lecejeff/dsPeak/Hardware/Daughter Card/v1_00-0a/pcb output files/step/Daughter_card-v1_00-0a.stp

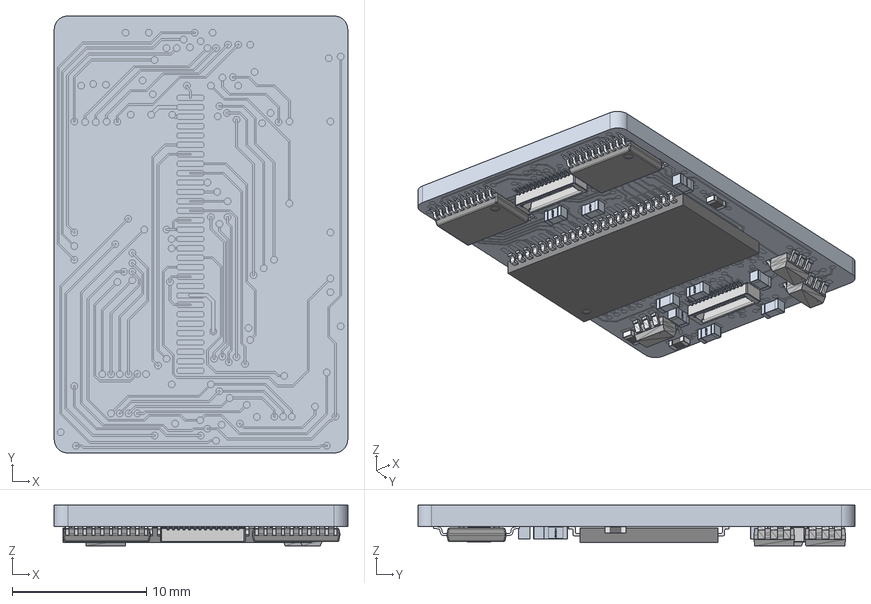
[picture p1: CAD file, 2021-03-09]
Hardware/Daughter Card/v1_00-0a/pcb output files/step/Daughter_card-v1_00-0a.stp
21.8 x 32.5 x 3.05 mm
BOARD_OUTLINE
CIRCLE_50801 x 120
RECTROUND_3988.000000_19990.000000_1321.000000_11111 x 30
TRACES_TOP
SHAPES_TOP
CIRCLE_50804 x 120
RECTROUND_5994.000000_9500.000000_991.000000_11114 x 24
RECTROUND_5994.000000_10998.000000_991.000000_11114 x 15
RECTROUND_15494.000000_2489.000000_838.000000_11114 x 40
RECTROUND_2007.000000_7010.000000_660.000000_11114 x 48
RECTROUND_3505.000000_7010.000000_660.000000_11114 x 8
RECTROUND_21996.000000_4089.000000_1372.000000_11114 x 44
TRACES_BOTTOM
SHAPES_BOTTOM
RESC1608X50N_EIA_0603_METRIC_1608_157x085x050 x 3
product x 3
BODY-TSSOP x 2
LEAD-TSSOP x 40
PIN1 x 2
DF40C-30DP-0.4Vnew x 2
leg_TSSOP44 x 264
Part TSSOP44
