lecejeff/dsPeak/Hardware/v1_00-0a/3dprints/dsPeak top.stl

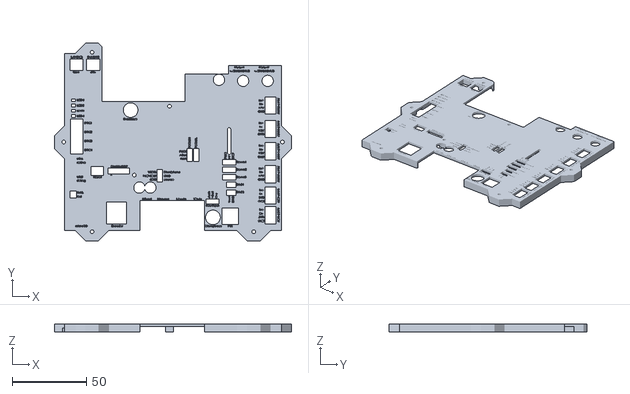
[picture p2: CAD file, 2021-01-17]
Hardware/v1_00-0a/3dprints/dsPeak top.stl
159.4 x 132.8 x 5.71
