lecejeff/dsPeak/Hardware/v1_00-0a/3dprints/dsPeak base.stl

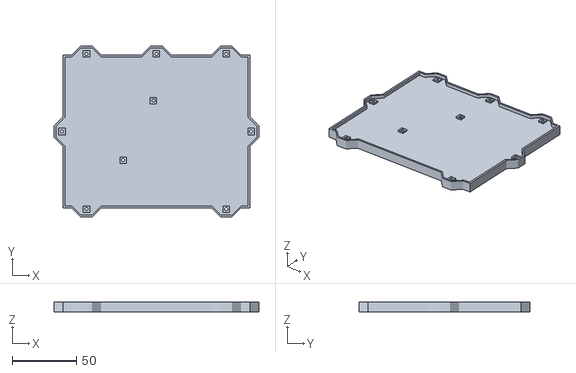
[picture p3: CAD file, 2021-01-17]
Hardware/v1_00-0a/3dprints/dsPeak base.stl
159.4 x 132.8 x 8.00
