lecejeff/dsPeak/Hardware/v1_00-0b/schema_pdf/dspeak-v1_00-0b-PCB.pdf

# ART FILM - TOP

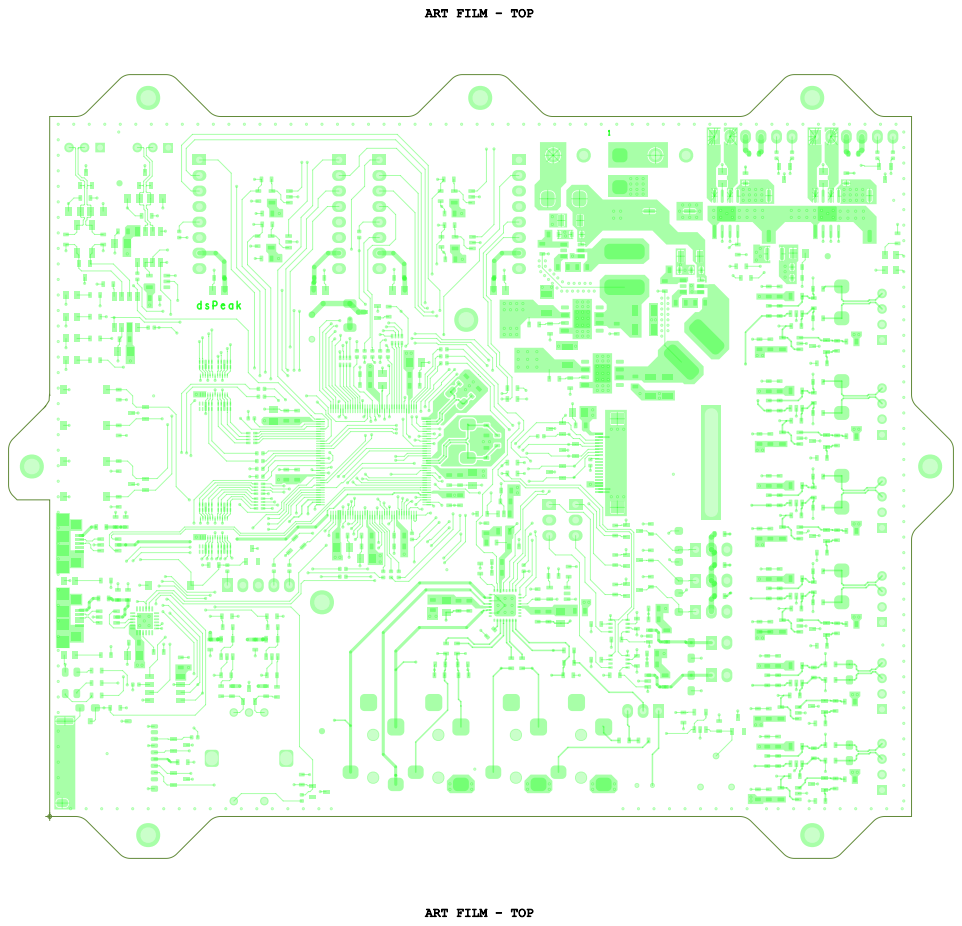
[picture p4: page 1]
dsPeak

ART FILM - TOP

# ART FILM - INNER1

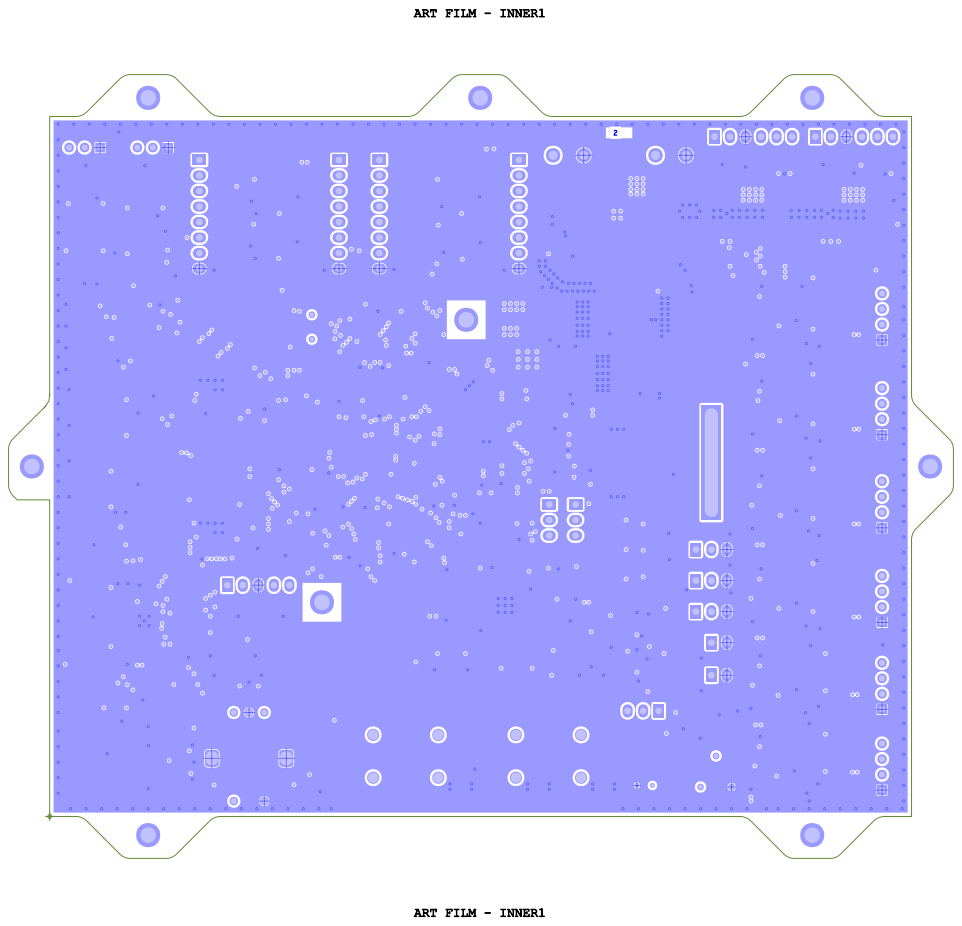
[picture p5: page 2]
ART FILM - INNER1

# ART FILM - INNER2

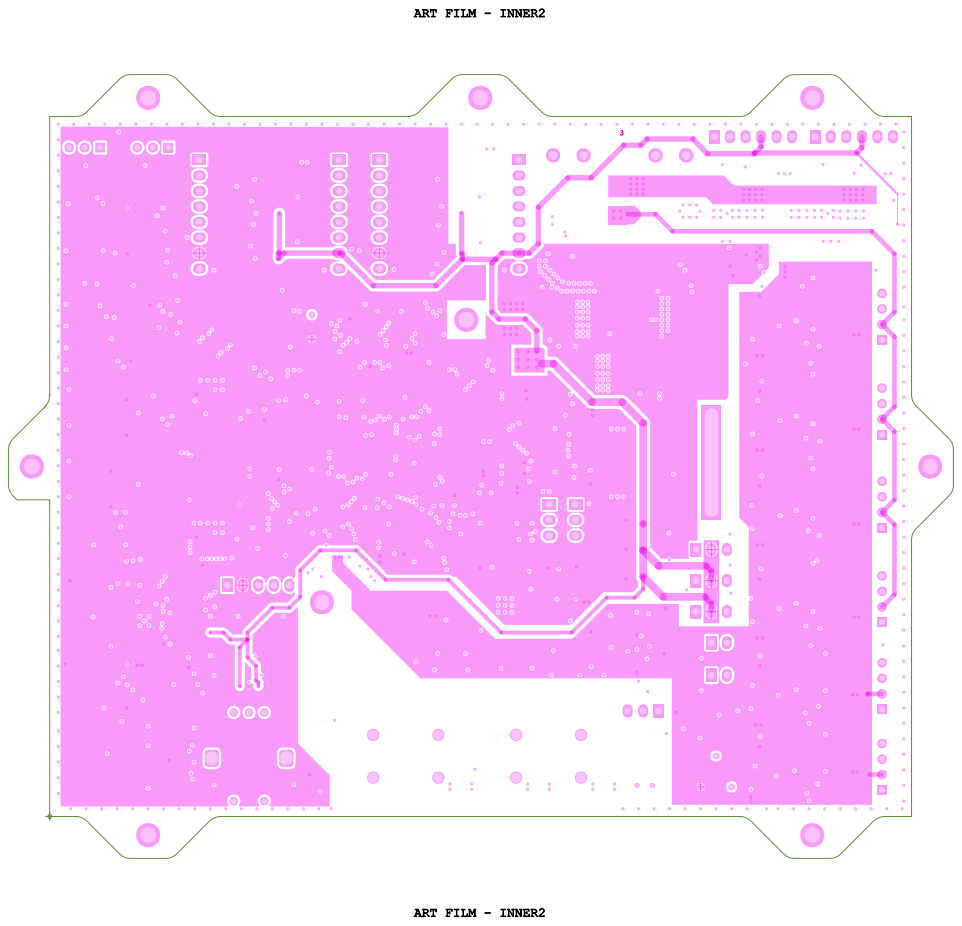
[picture p6: page 3]
ART FILM - INNER2

# ART FILM - BOTTOM

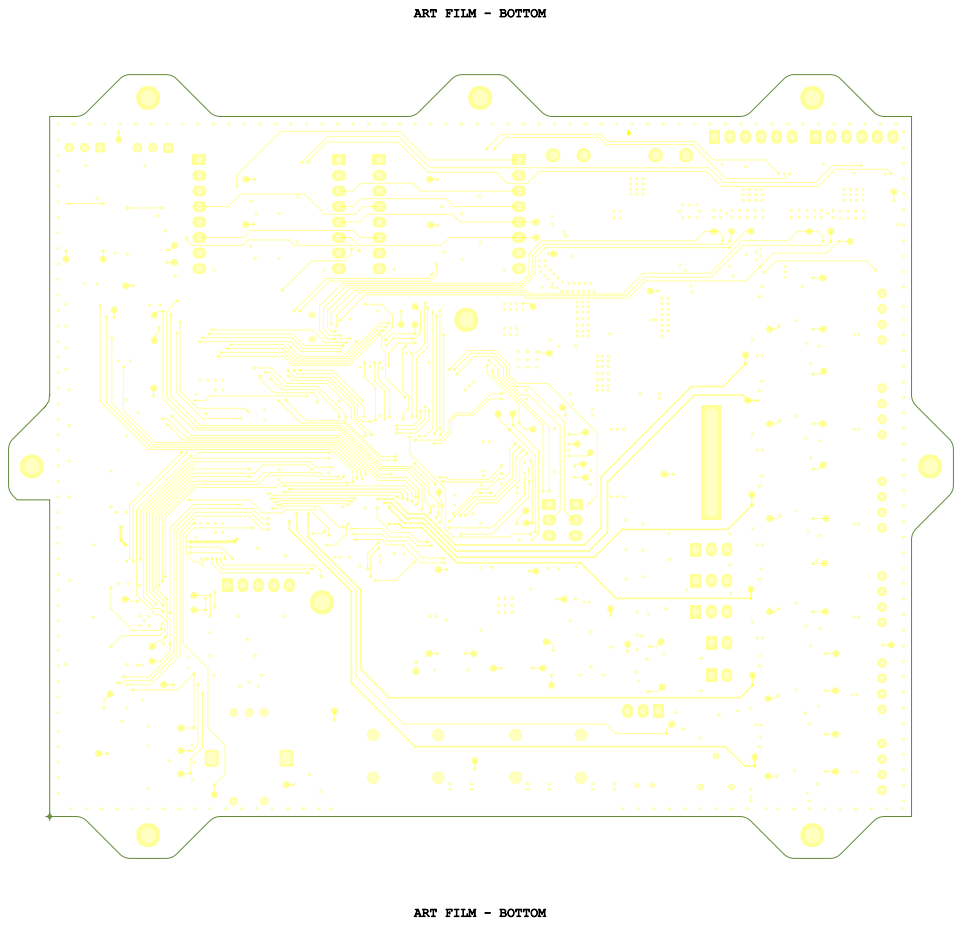
[picture p7: page 4]

ART FILM - BOTTOM

# ART FILM - SoldermaskTop

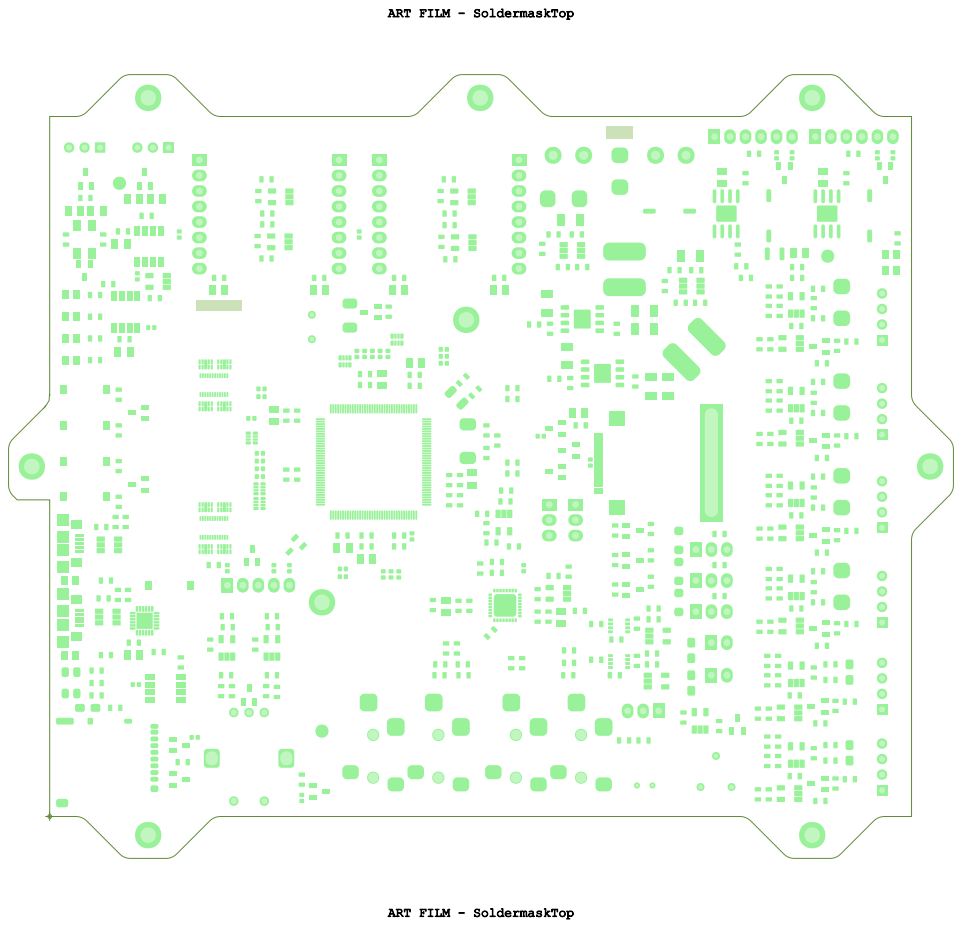
[picture p8: page 5]

ART FILM - SoldermaskTop

# ART FILM - SoldermaskBot

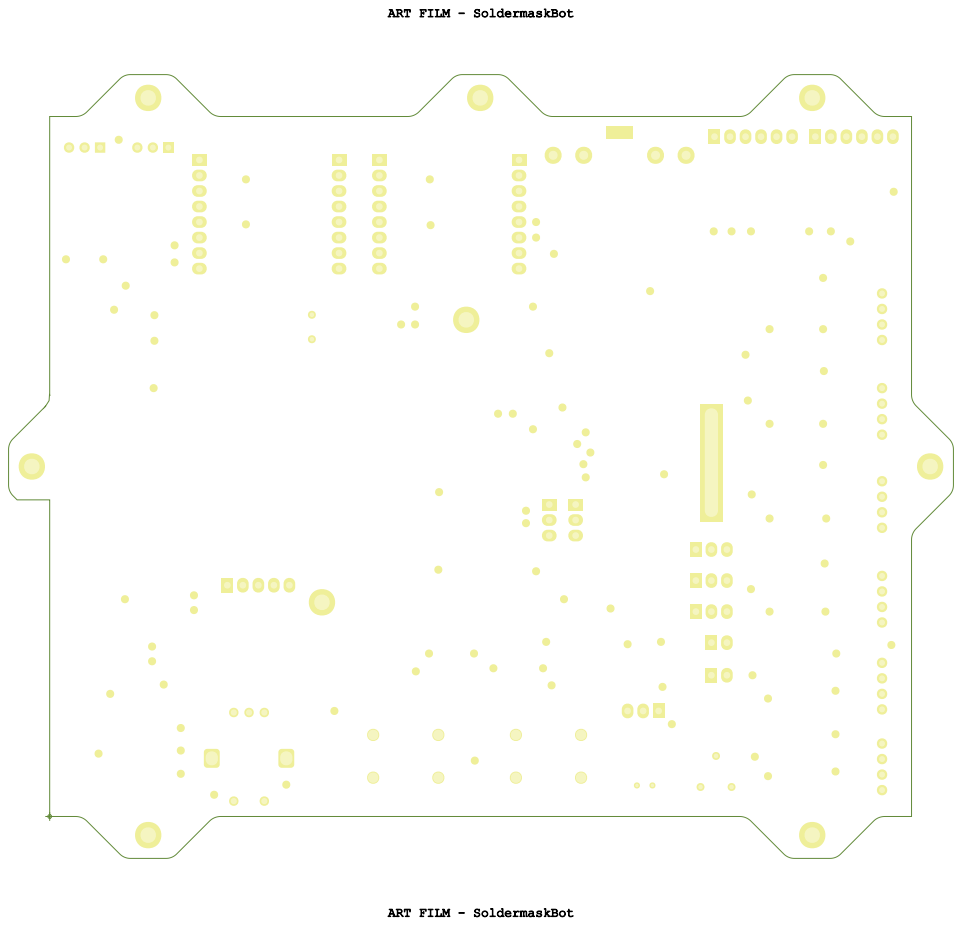
[picture p9: page 6]

ART FILM - SoldermaskBot

# ART FILM - SilkscreenTop

D49R57

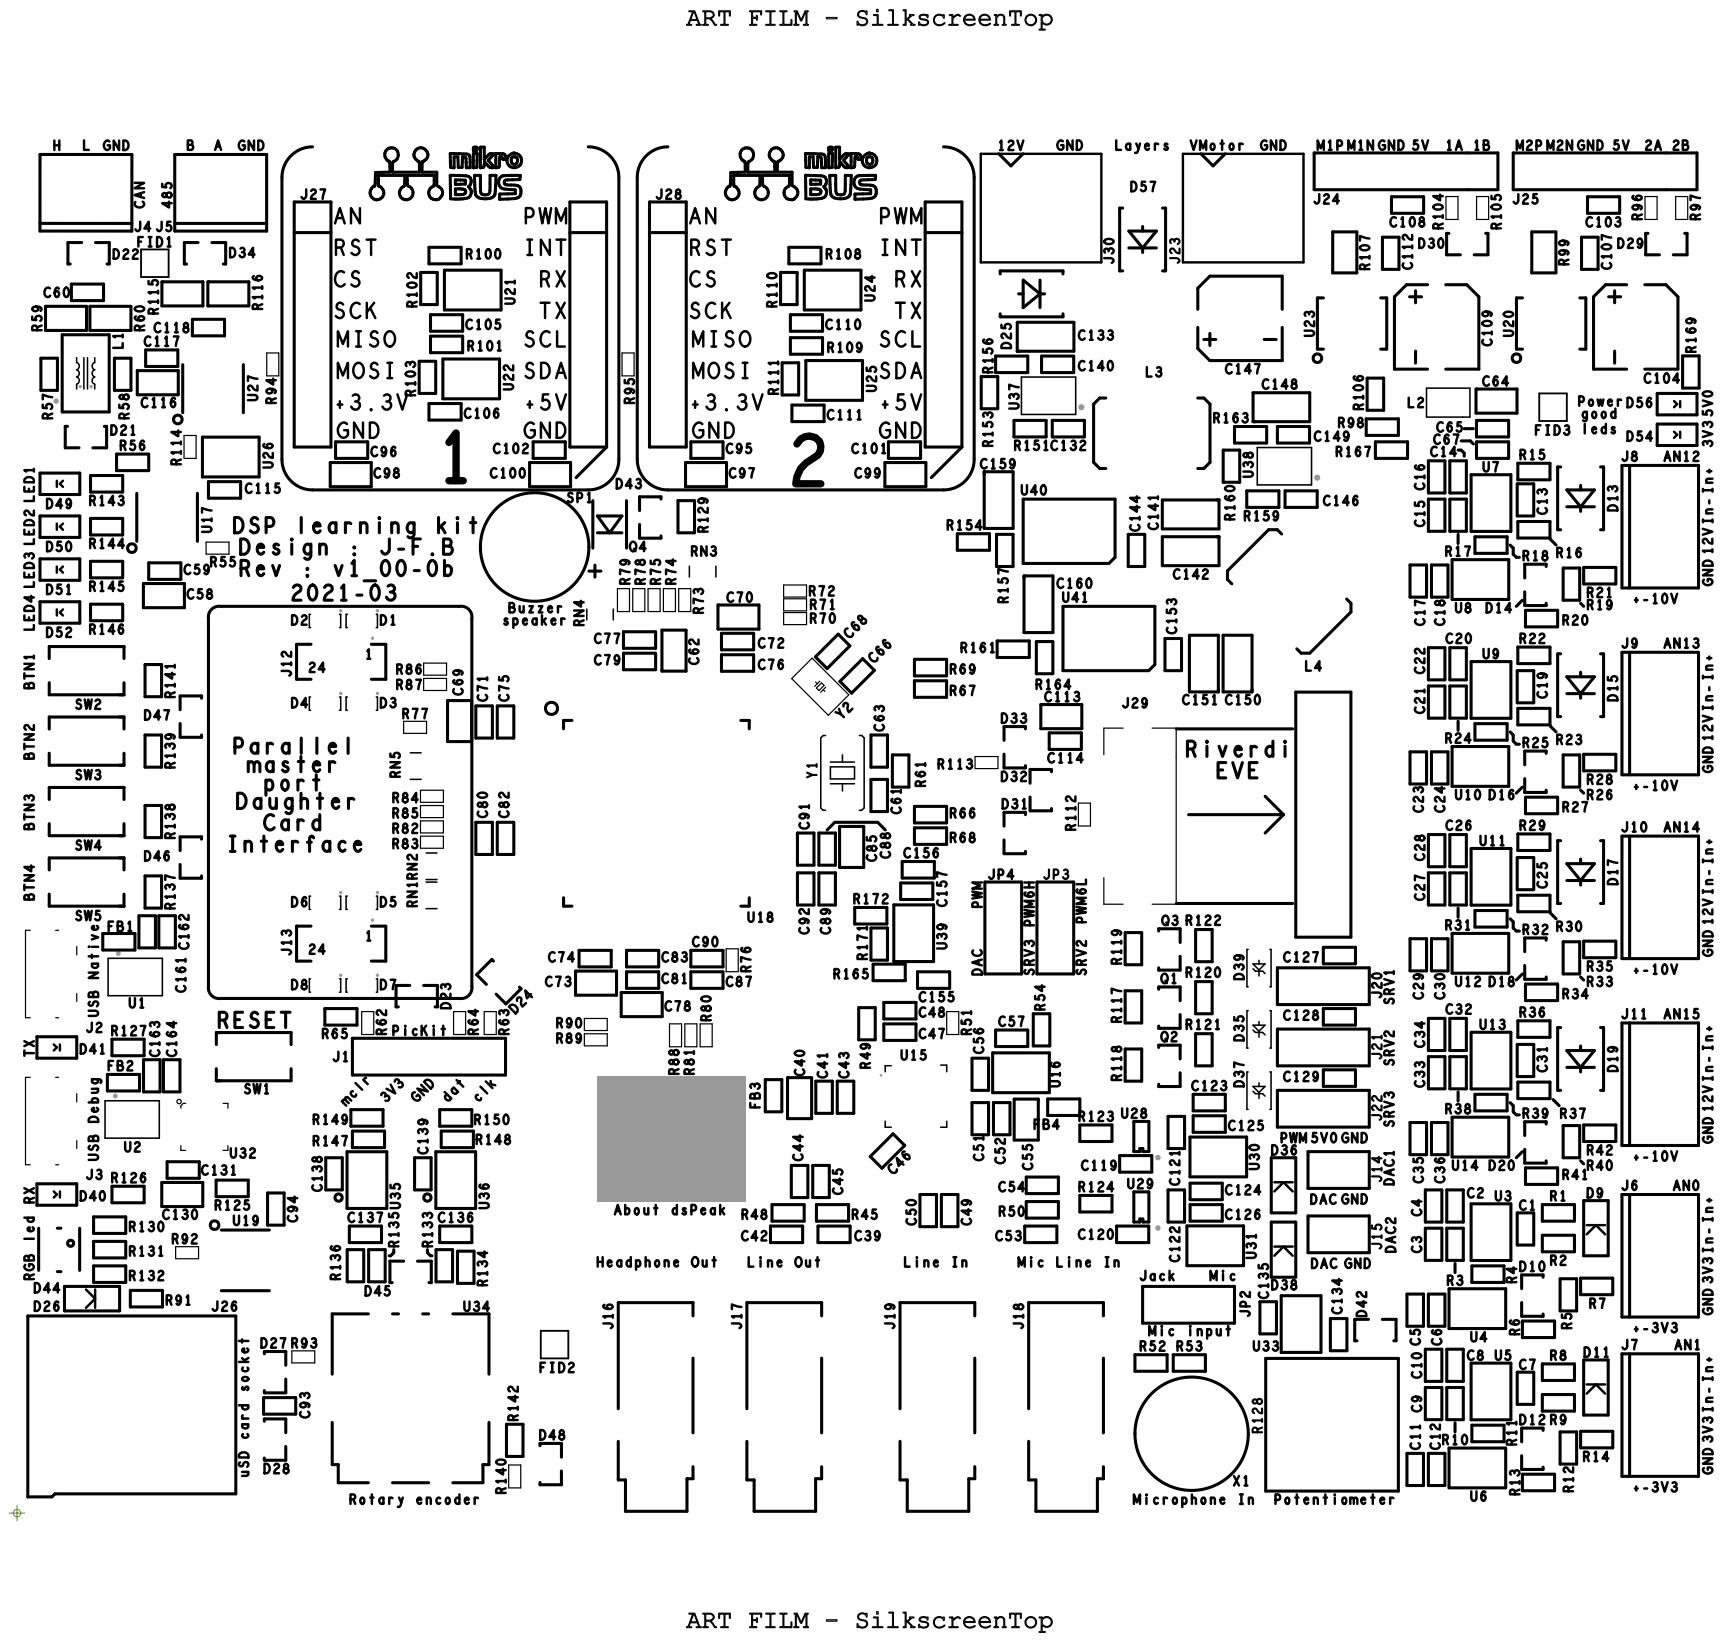
[picture p10: page 7]

3V3 GND In+ In- GND In- 3V3 In+ GND In- 12V In+ GND In- 12V In+ 12V GND In+ In- GND 12V In- In+ 3V3 5V0

RGB led D44 RX TX BTN4 BTN3 BTN2 BTN1 LED4

# ART FILM - SilkscreenBot

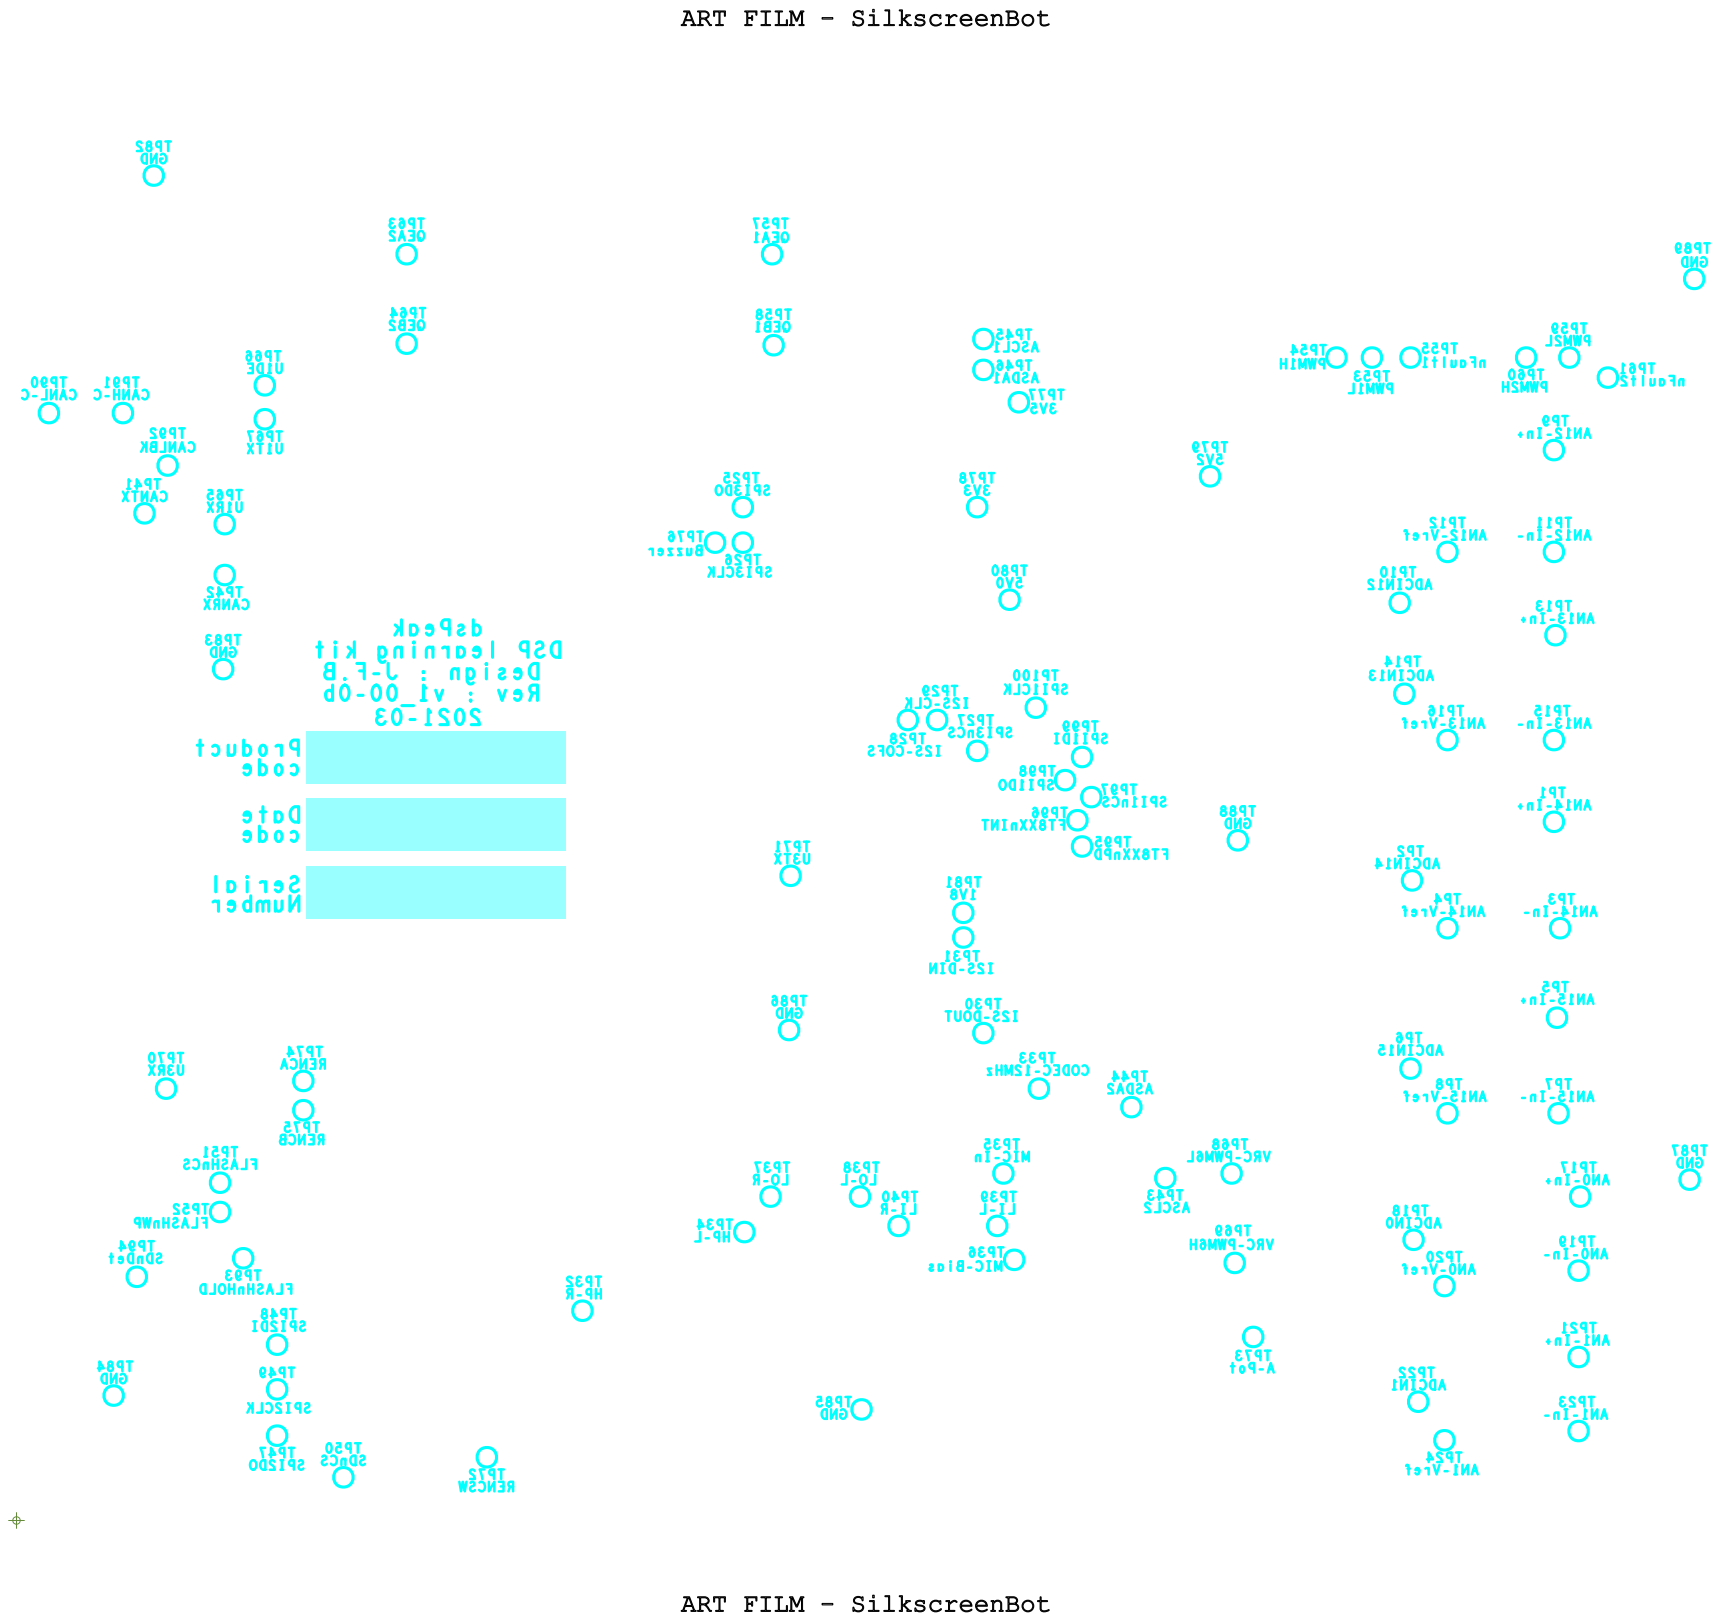
[picture p11: page 8]

# ART FILM - Outline

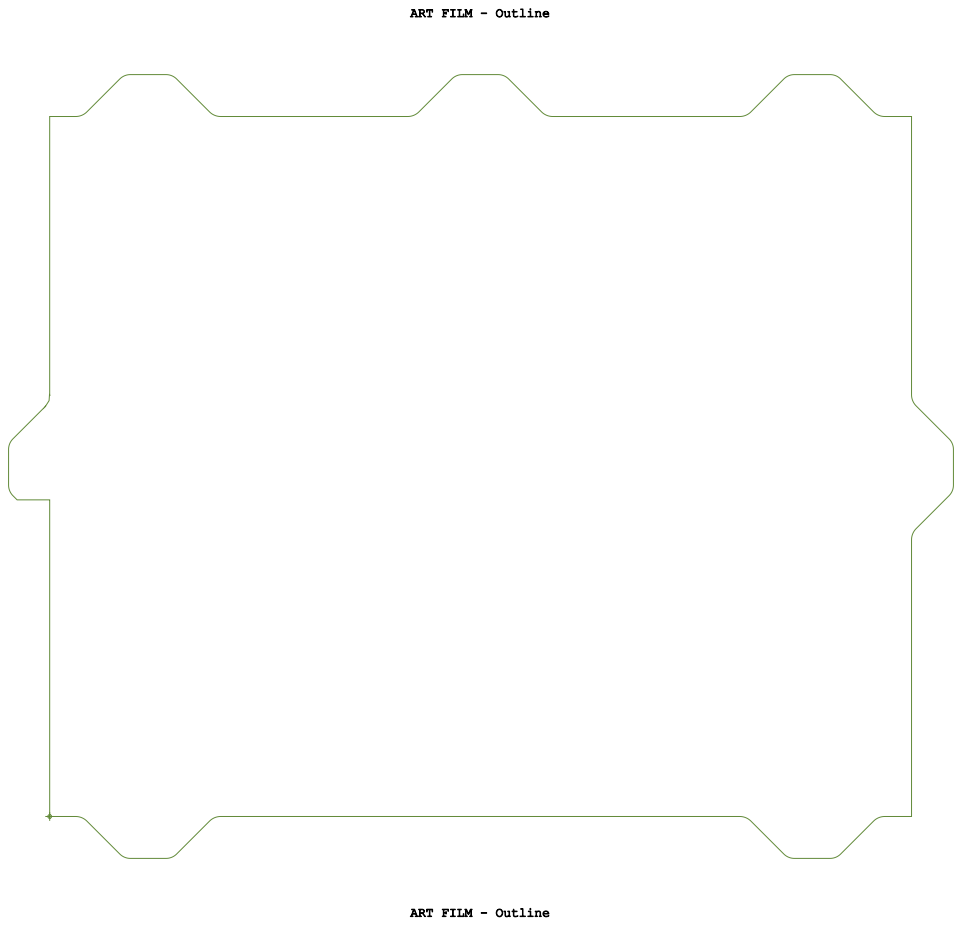
[picture p12: page 9]

ART FILM - Outline
