lecejeff/dsPeak/Hardware/v1_00-0a/schema_pdf/dspeak-v1_00-0a-SCH.pdf

CAN_TX CAN_RX CAN_LBK UART1_TX UART1_RTS UART1_CTS UART1_RX MKB1_AIN MKB1_PWM MKB1_INT MKB1_nCS MKB1_RST ASDA1 ASCL1 UART2_TX UART2_RX SPI4_MISO SPI4_MOSI SPI4_SCLK MKB2_AIN MKB2_PWM MKB2_INT MKB2_nCS MKB2_RST

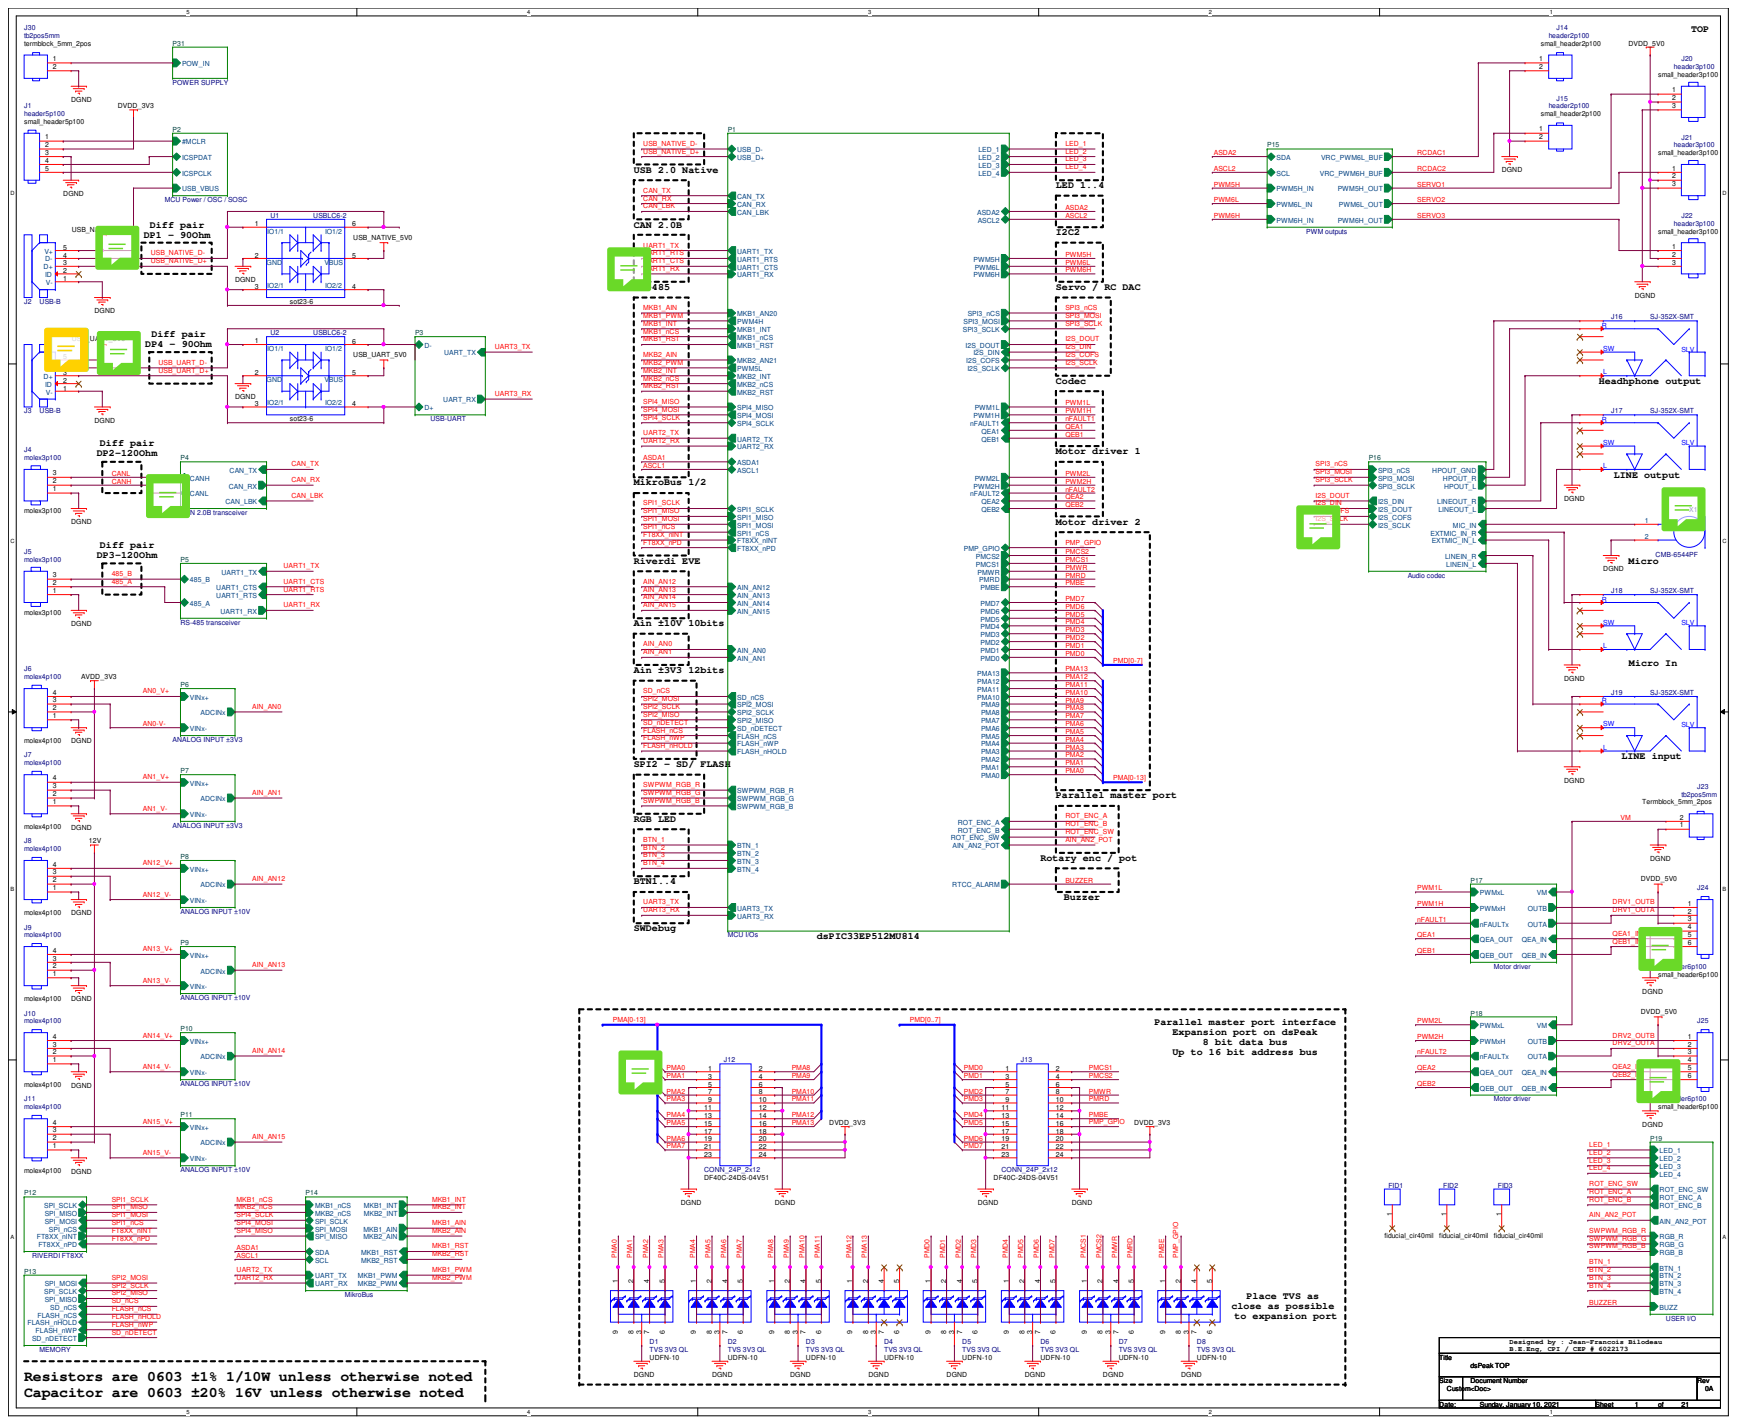
[picture p13: page 1]

USB_VBUS
MCU Power / OSC / SOSC

Parallel master port interface
Expansion port on dsPeak

Up to 16 bit address bus

Designed by : Jean-Francois Bilodeau
B.E.Eng, CPI / CEP # 6022173

Resistors are 0603 ±1% 1/10W unless otherwise noted
Capacitor are 0603 ±20% 16V unless otherwise noted

D D

# Analog input ±10V

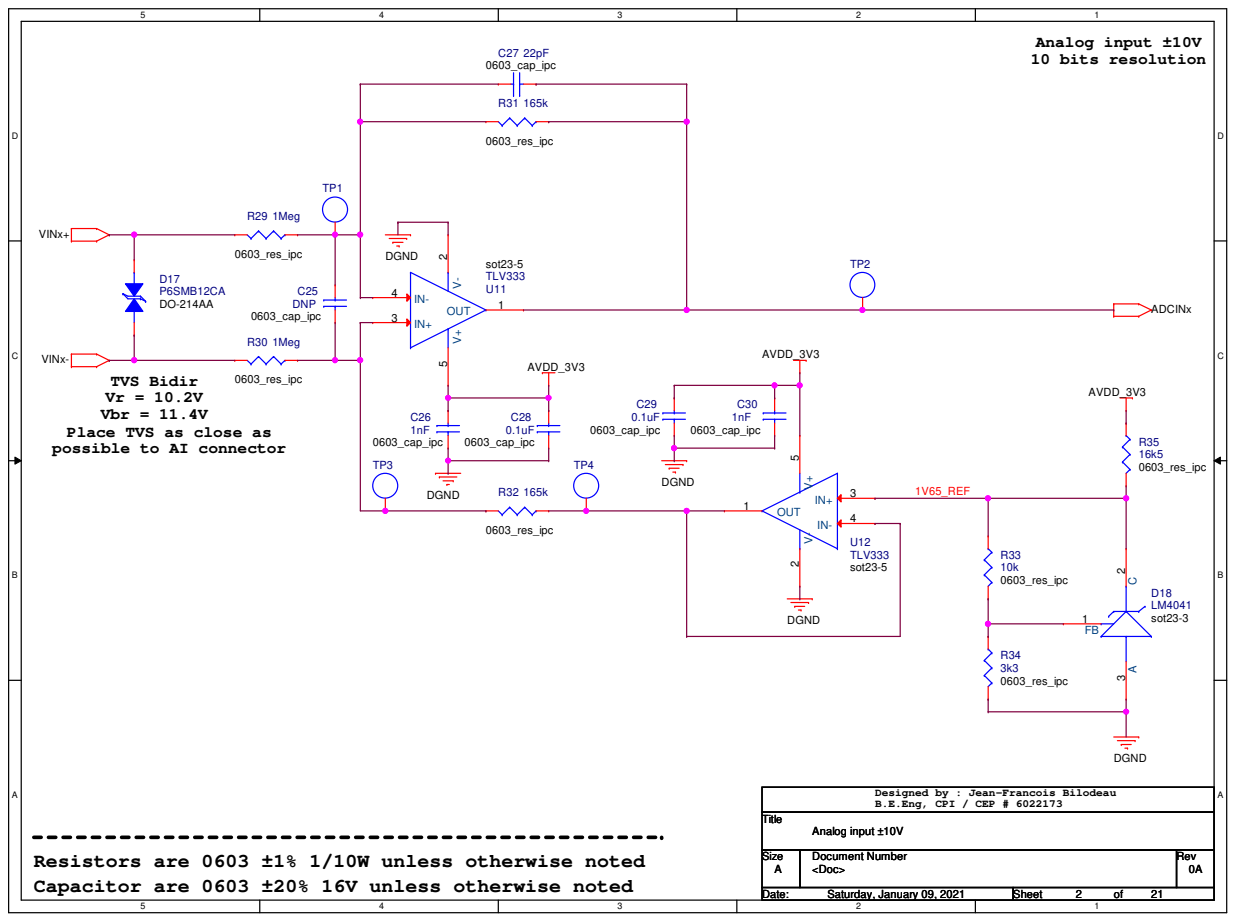
[picture p14: page 2]

TVS Bidir
Vbr = 11.4V
Place TVS as close as
possible to AI connector

Designed by : Jean-Francois Bilodeau
B.E.Eng, CPI / CEP # 6022173

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

D D

# Analog input ±10V

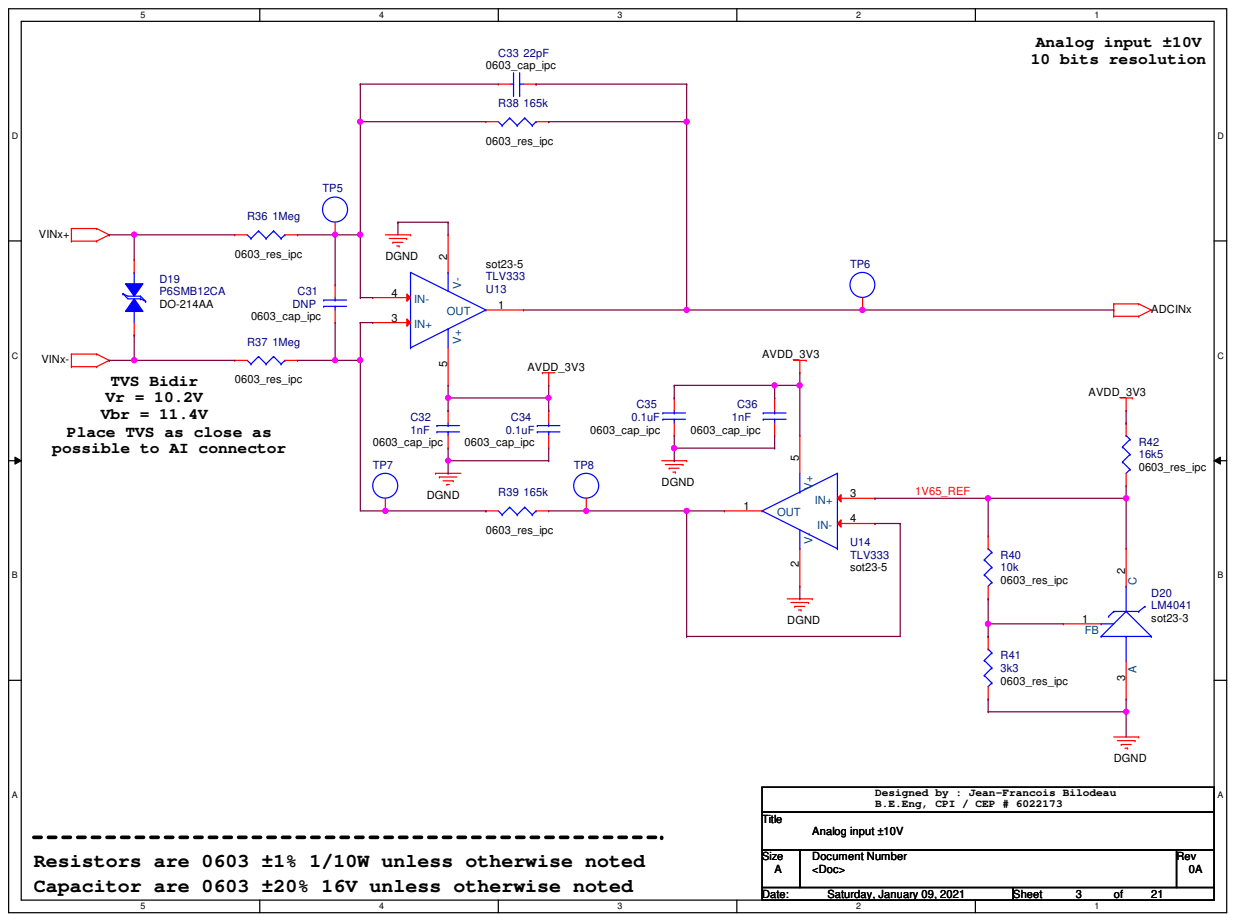
[picture p15: page 3]

TVS Bidir
Vbr = 11.4V
Place TVS as close as
possible to AI connector

Designed by : Jean-Francois Bilodeau
B.E.Eng, CPI / CEP # 6022173

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

D D

# Analog input ±10V

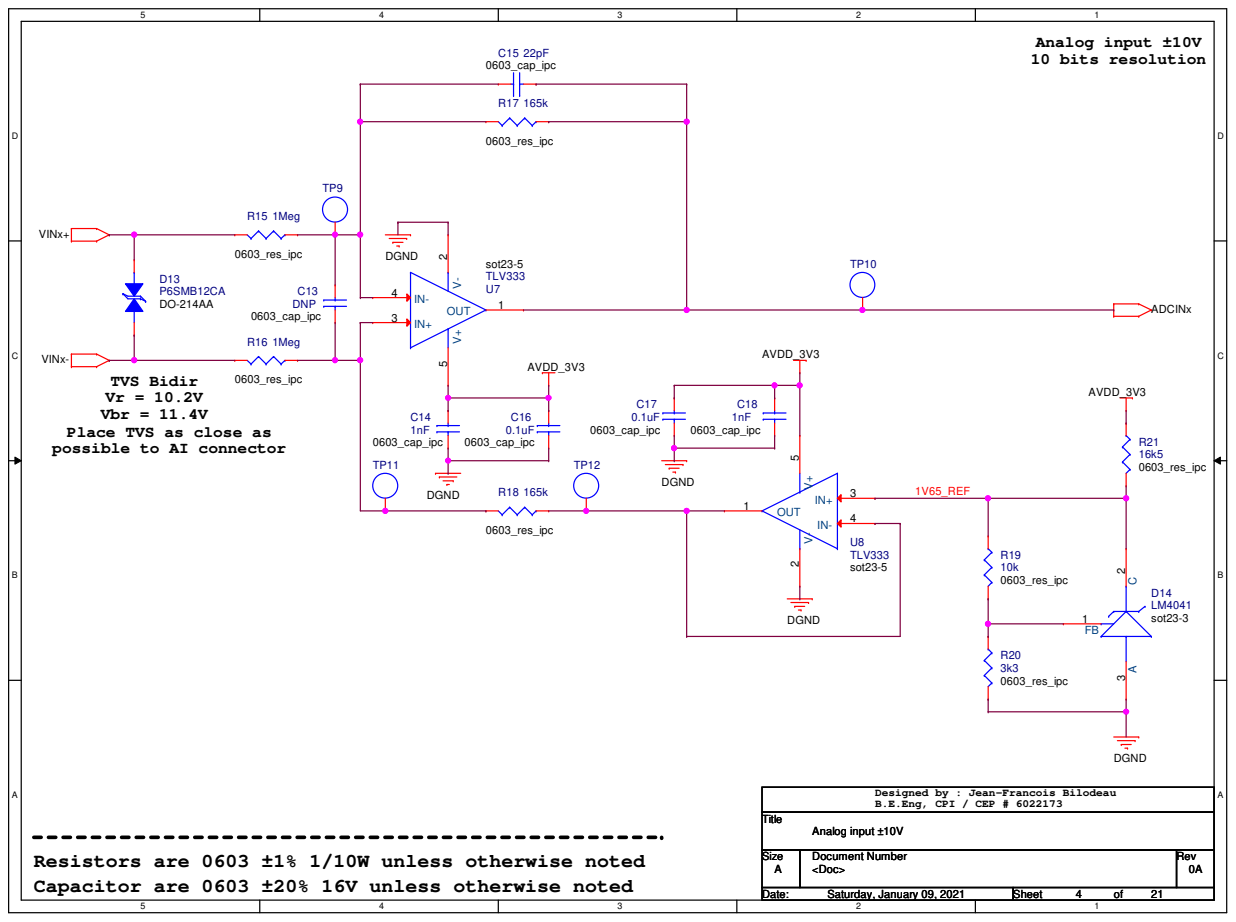
[picture p16: page 4]

TVS Bidir
Vbr = 11.4V
Place TVS as close as
possible to AI connector

Designed by : Jean-Francois Bilodeau
B.E.Eng, CPI / CEP # 6022173

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

D D

# Analog input ±10V

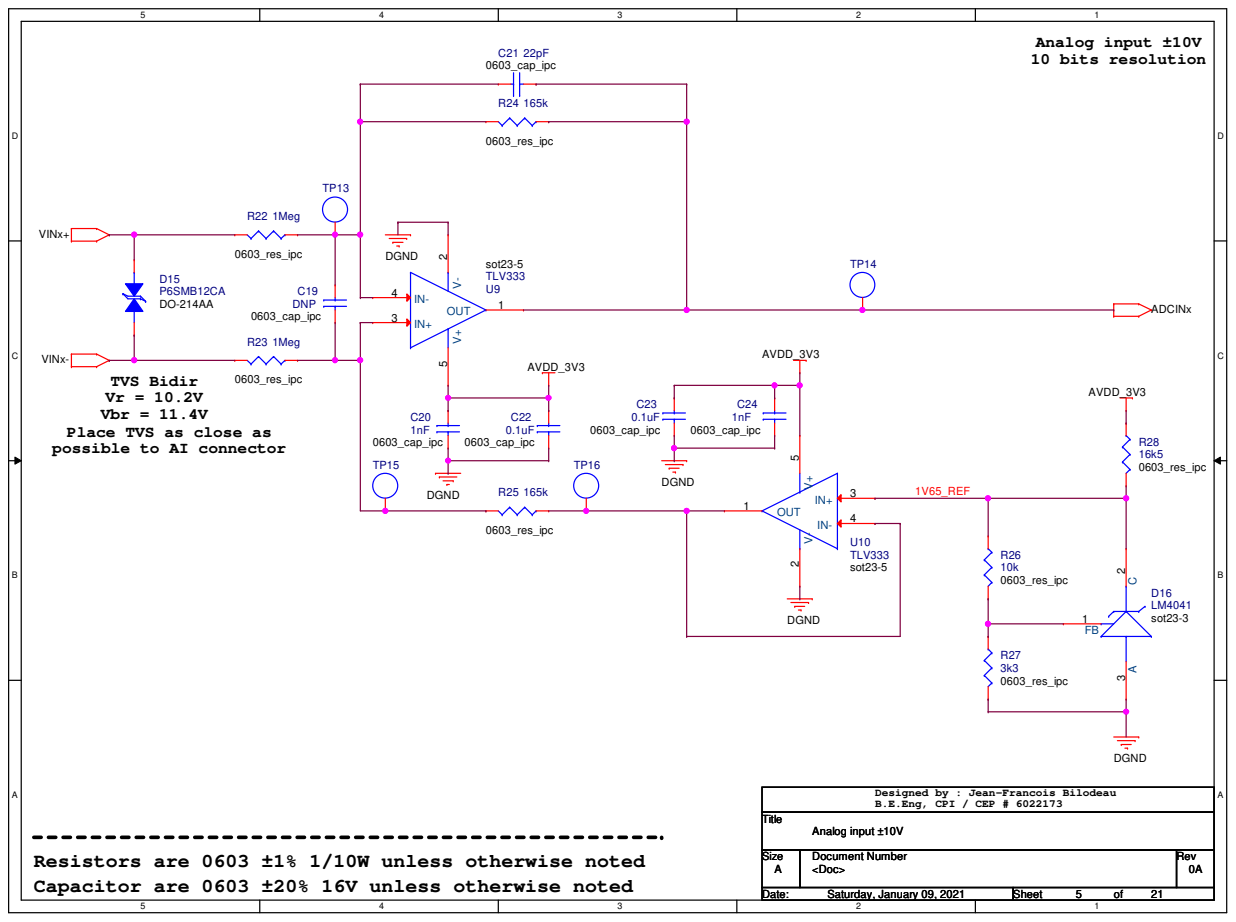
[picture p17: page 5]

TVS Bidir
Vbr = 11.4V
Place TVS as close as
possible to AI connector

Designed by : Jean-Francois Bilodeau
B.E.Eng, CPI / CEP # 6022173

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

D D

# Analog input ±3.3V

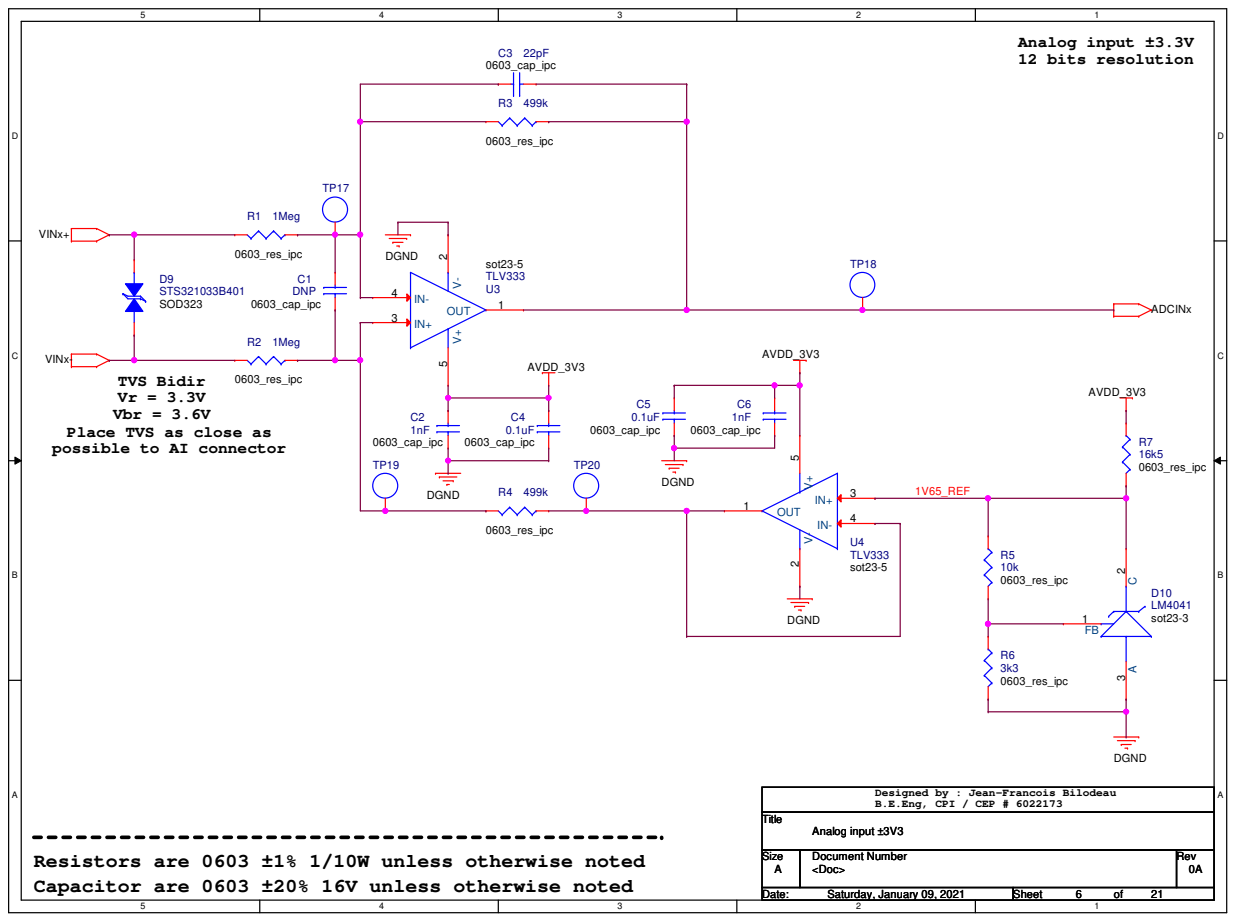
[picture p18: page 6]

Place TVS as close as
possible to AI connector

Designed by : Jean-Francois Bilodeau
B.E.Eng, CPI / CEP # 6022173

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

D D

# Analog input ±3.3V

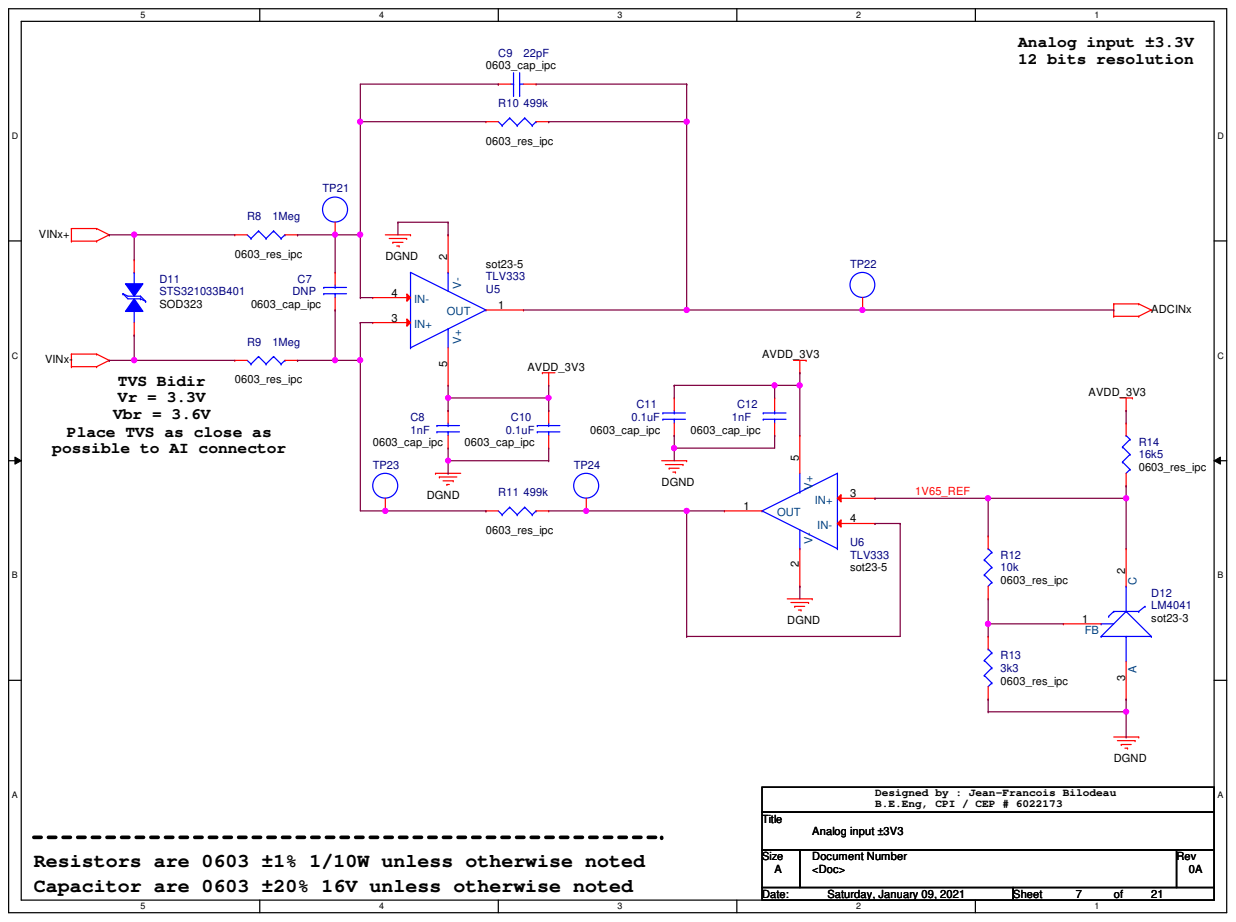
[picture p19: page 7]

Place TVS as close as
possible to AI connector

Designed by : Jean-Francois Bilodeau
B.E.Eng, CPI / CEP # 6022173

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

### Place as close as possible to IC pin

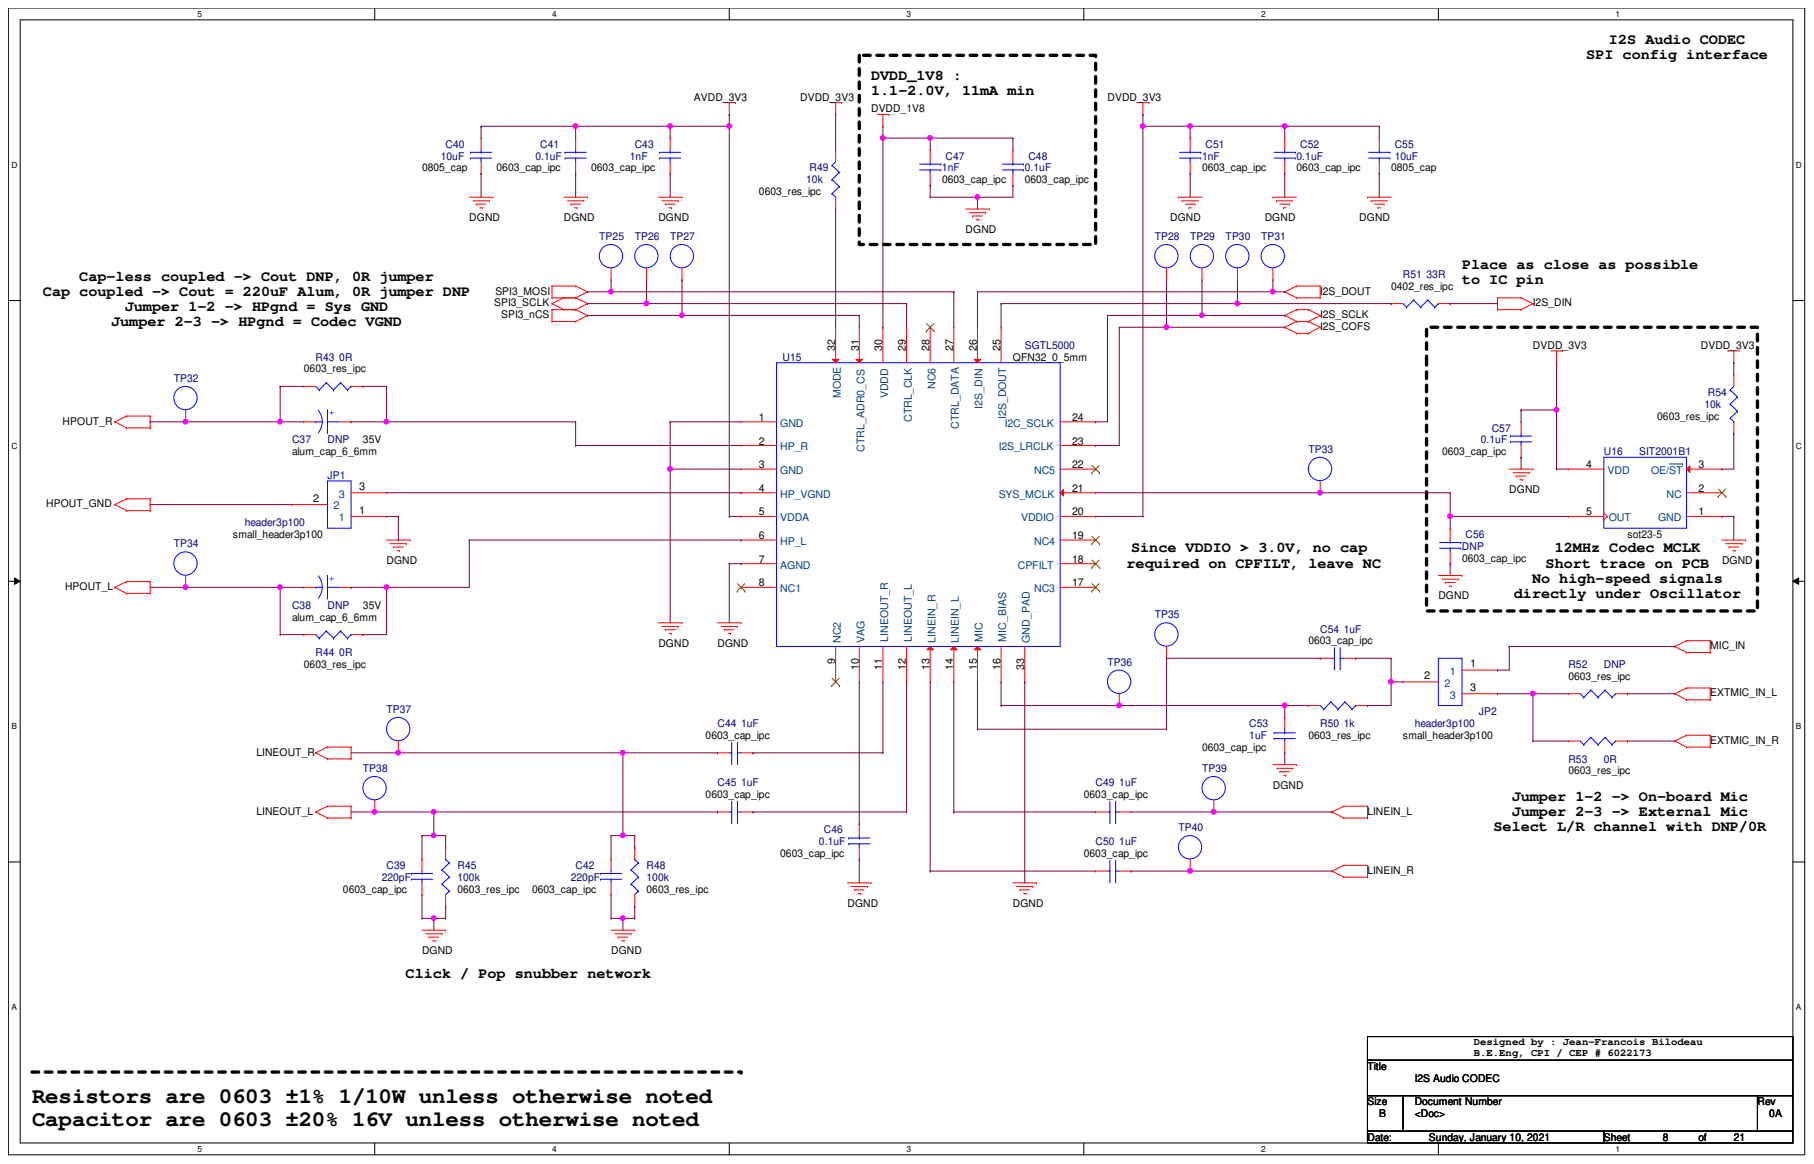
[picture p20: page 8]

Cap-less coupled -> Cout DNP, 0R jumper
Cap coupled -> Cout = 220uF Alum, 0R jumper DNP

Jumper 1-2 -> HPgnd = Sys GND
Jumper 2-3 -> HPgnd = Codec VGND

Since VDDIO > 3.0V, no cap
required on CPFILT, leave NC

12MHz Codec MCLK
Short trace on PCB
No high-speed signals
directly under Oscillator

Jumper 1-2 -> On-board Mic
Jumper 2-3 -> External Mic
Select L/R channel with DNP/0R

Click / Pop snubber network

Designed by : Jean-Francois Bilodeau
B.E.Eng, CPI / CEP # 6022173

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

D D

# CAN bus interface

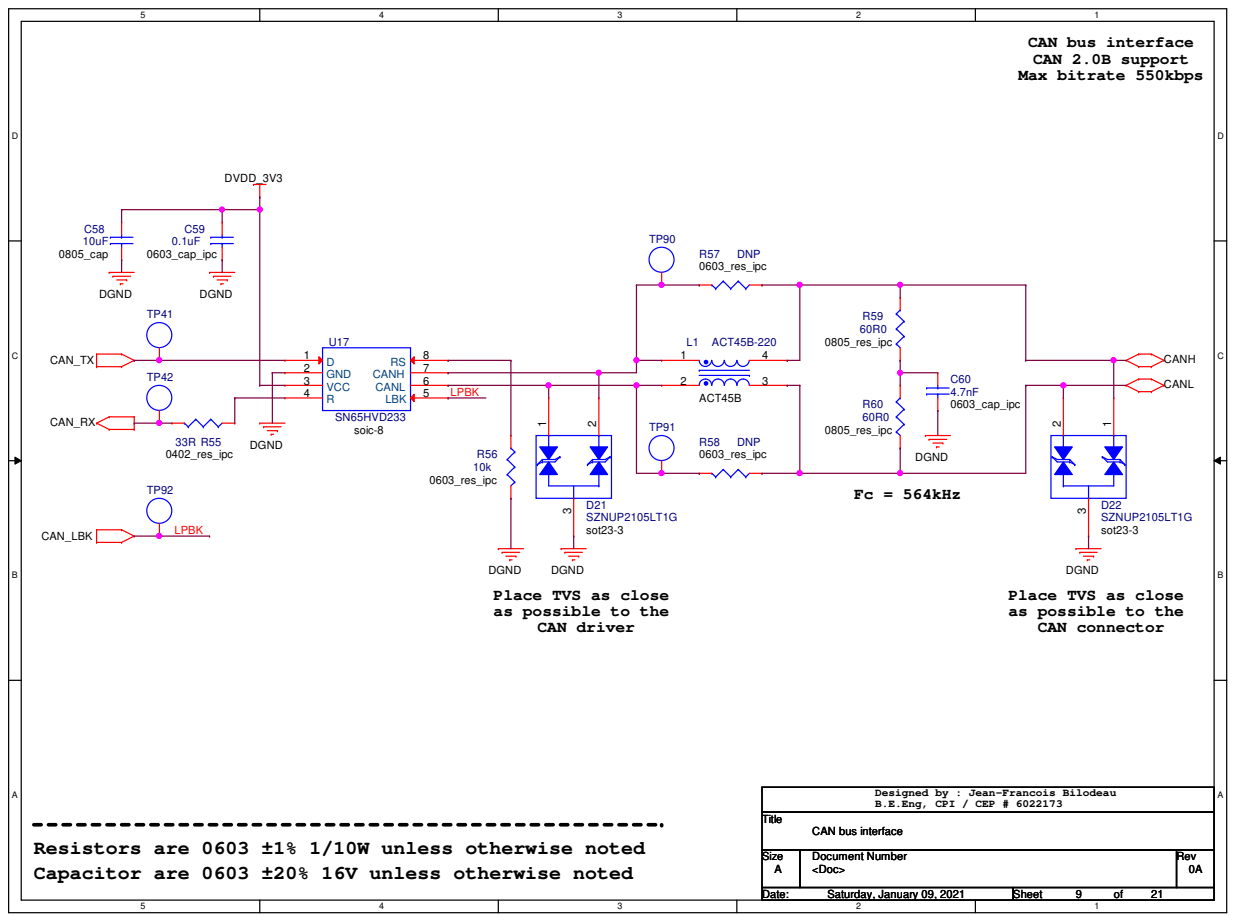
[picture p21: page 9]

Place TVS as close
as possible to the

CAN connector

Designed by : Jean-Francois Bilodeau
B.E.Eng, CPI / CEP # 6022173

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

### MCU decoupling MCU oscillators

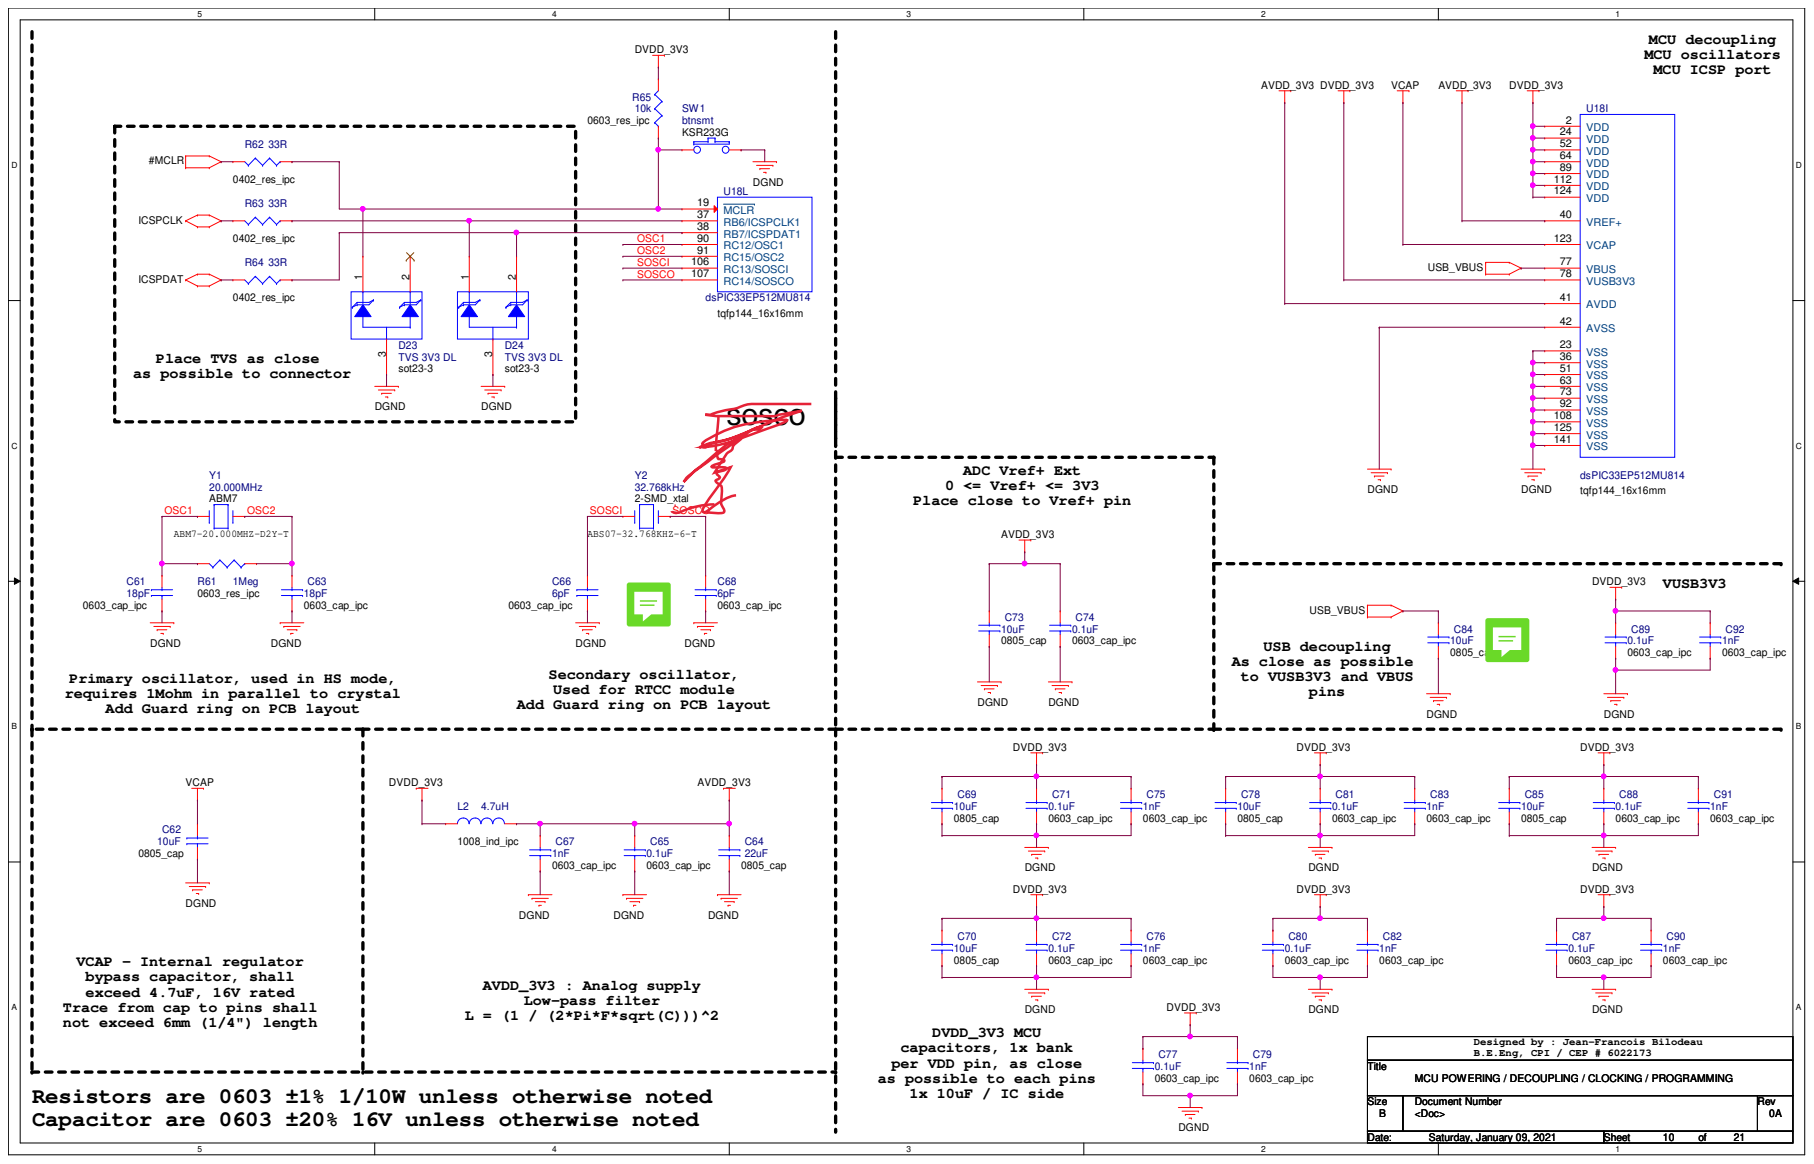
[picture p22: page 10]

Place TVS as close
as possible to connector

ADC Vref+ Ext
0 <= Vref+ <= 3V3
Place close to Vref+ pin

USB decoupling
As close as possible
to VUSB3V3 and VBUS

Primary oscillator, used in HS mode,
requires 1Mohm in parallel to crystal

Secondary oscillator,
Used for RTCC module
Add Guard ring on PCB layout

VCAP - Internal regulator
bypass capacitor, shall
exceed 4.7uF, 16V rated
Trace from cap to pins shall
not exceed 6mm (1/4") length

DVDD_3V3 MCU
capacitors, 1x bank
per VDD pin, as close
as possible to each pins
1x 10uF / IC side

Designed by : Jean-Francois Bilodeau
B.E.Eng, CPI / CEP # 6022173

MCU POWERING / DECOUPLING / CLOCKING / PROGRAMMING

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

### dsPIC33EP512MU814 GPIO pin mapping

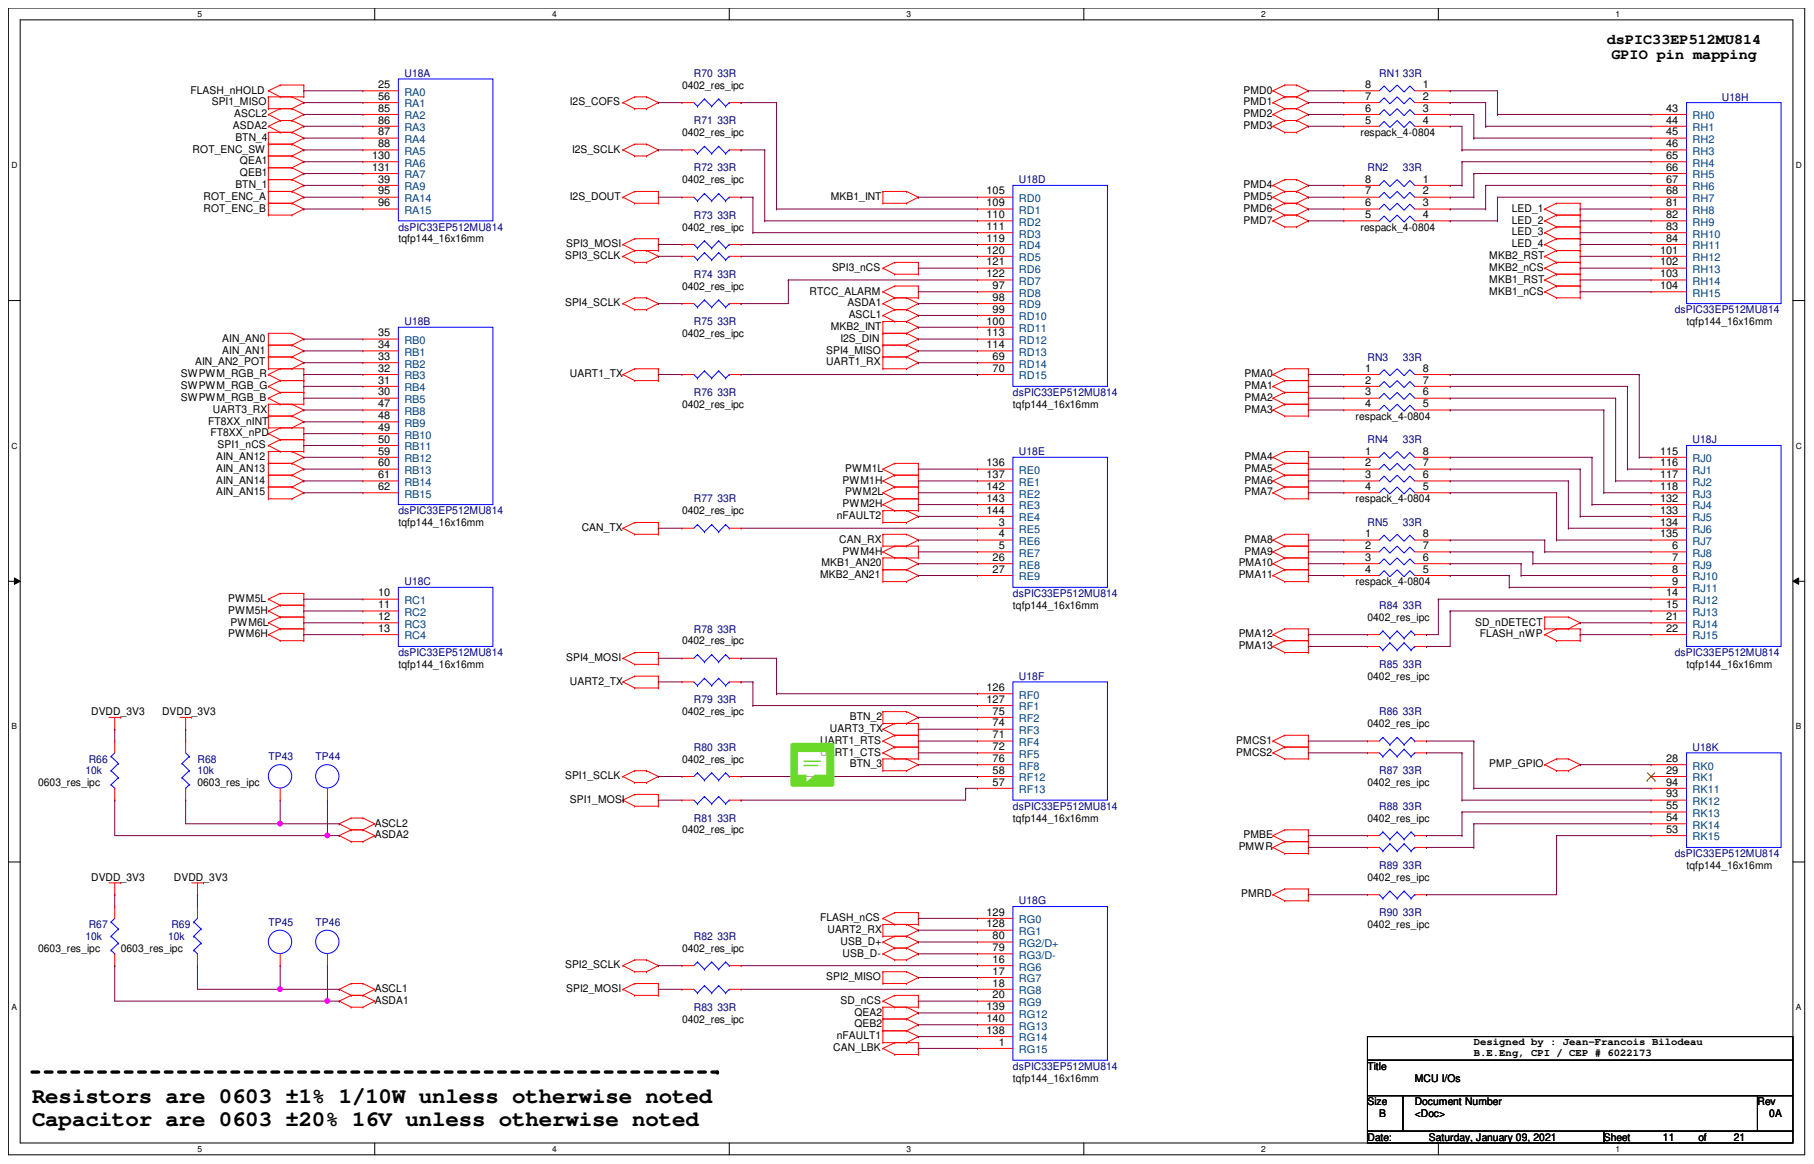
[picture p23: page 11]

Designed by : Jean-Francois Bilodeau
B.E.Eng, CPI / CEP # 6022173

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

D D

# Ext / Int memory

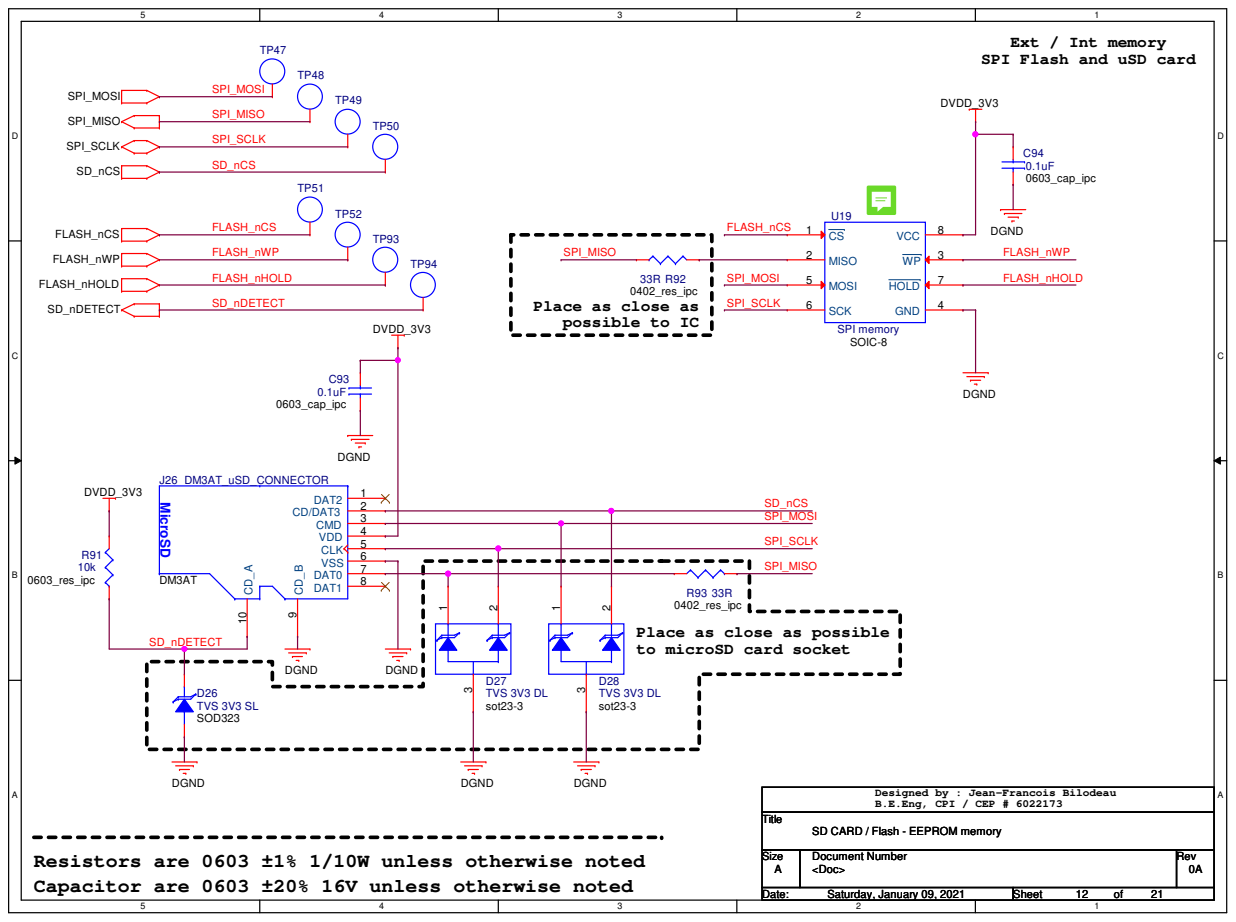
[picture p24: page 12]

SPI Flash and uSD card

Place as close as
possible to IC

0402_res_ipc
Place as close as possible
to microSD card socket

Designed by : Jean-Francois Bilodeau
B.E.Eng, CPI / CEP # 6022173

SD CARD / Flash - EEPROM memory

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

D D

# MikroBus port

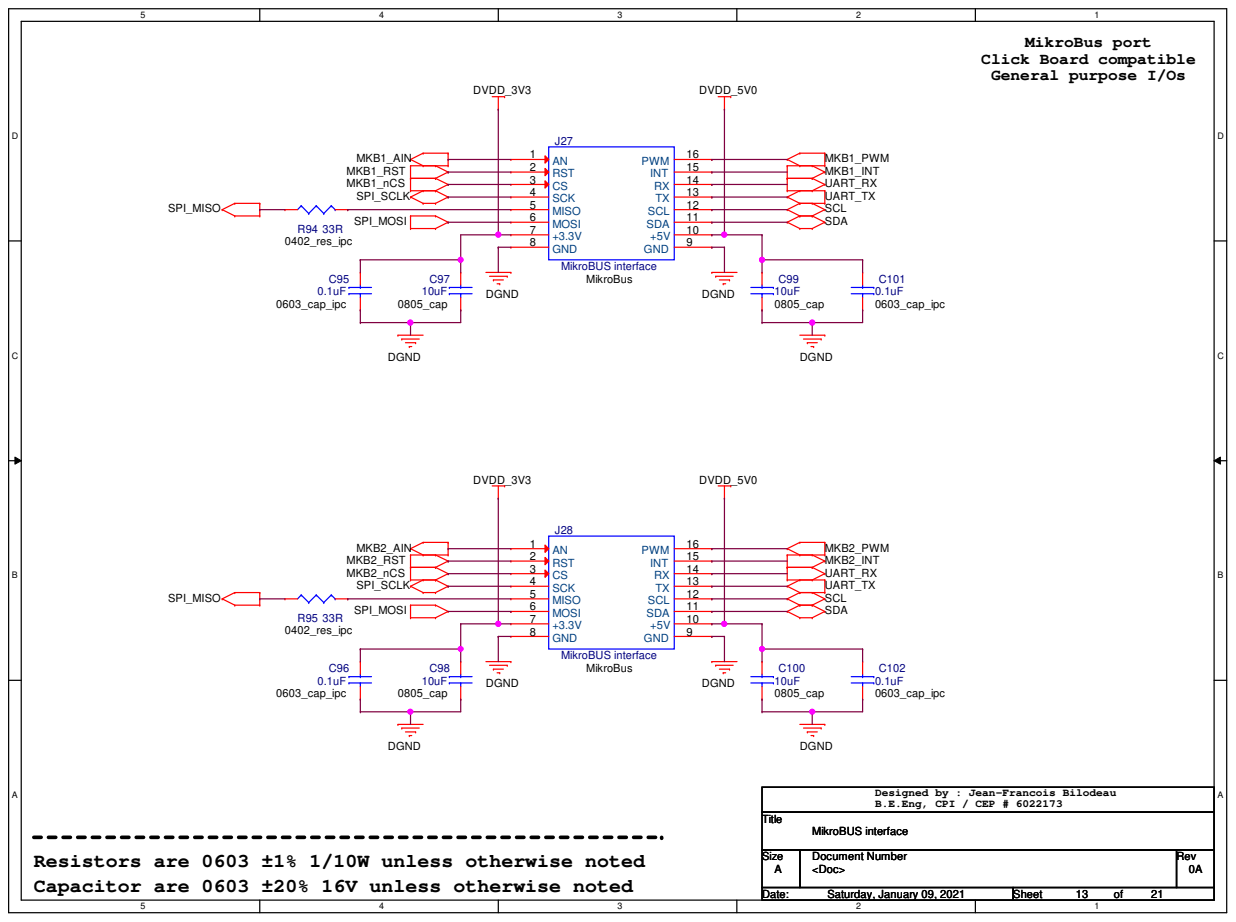
[picture p25: page 13]

Designed by : Jean-Francois Bilodeau
B.E.Eng, CPI / CEP # 6022173

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

### Voltage rating

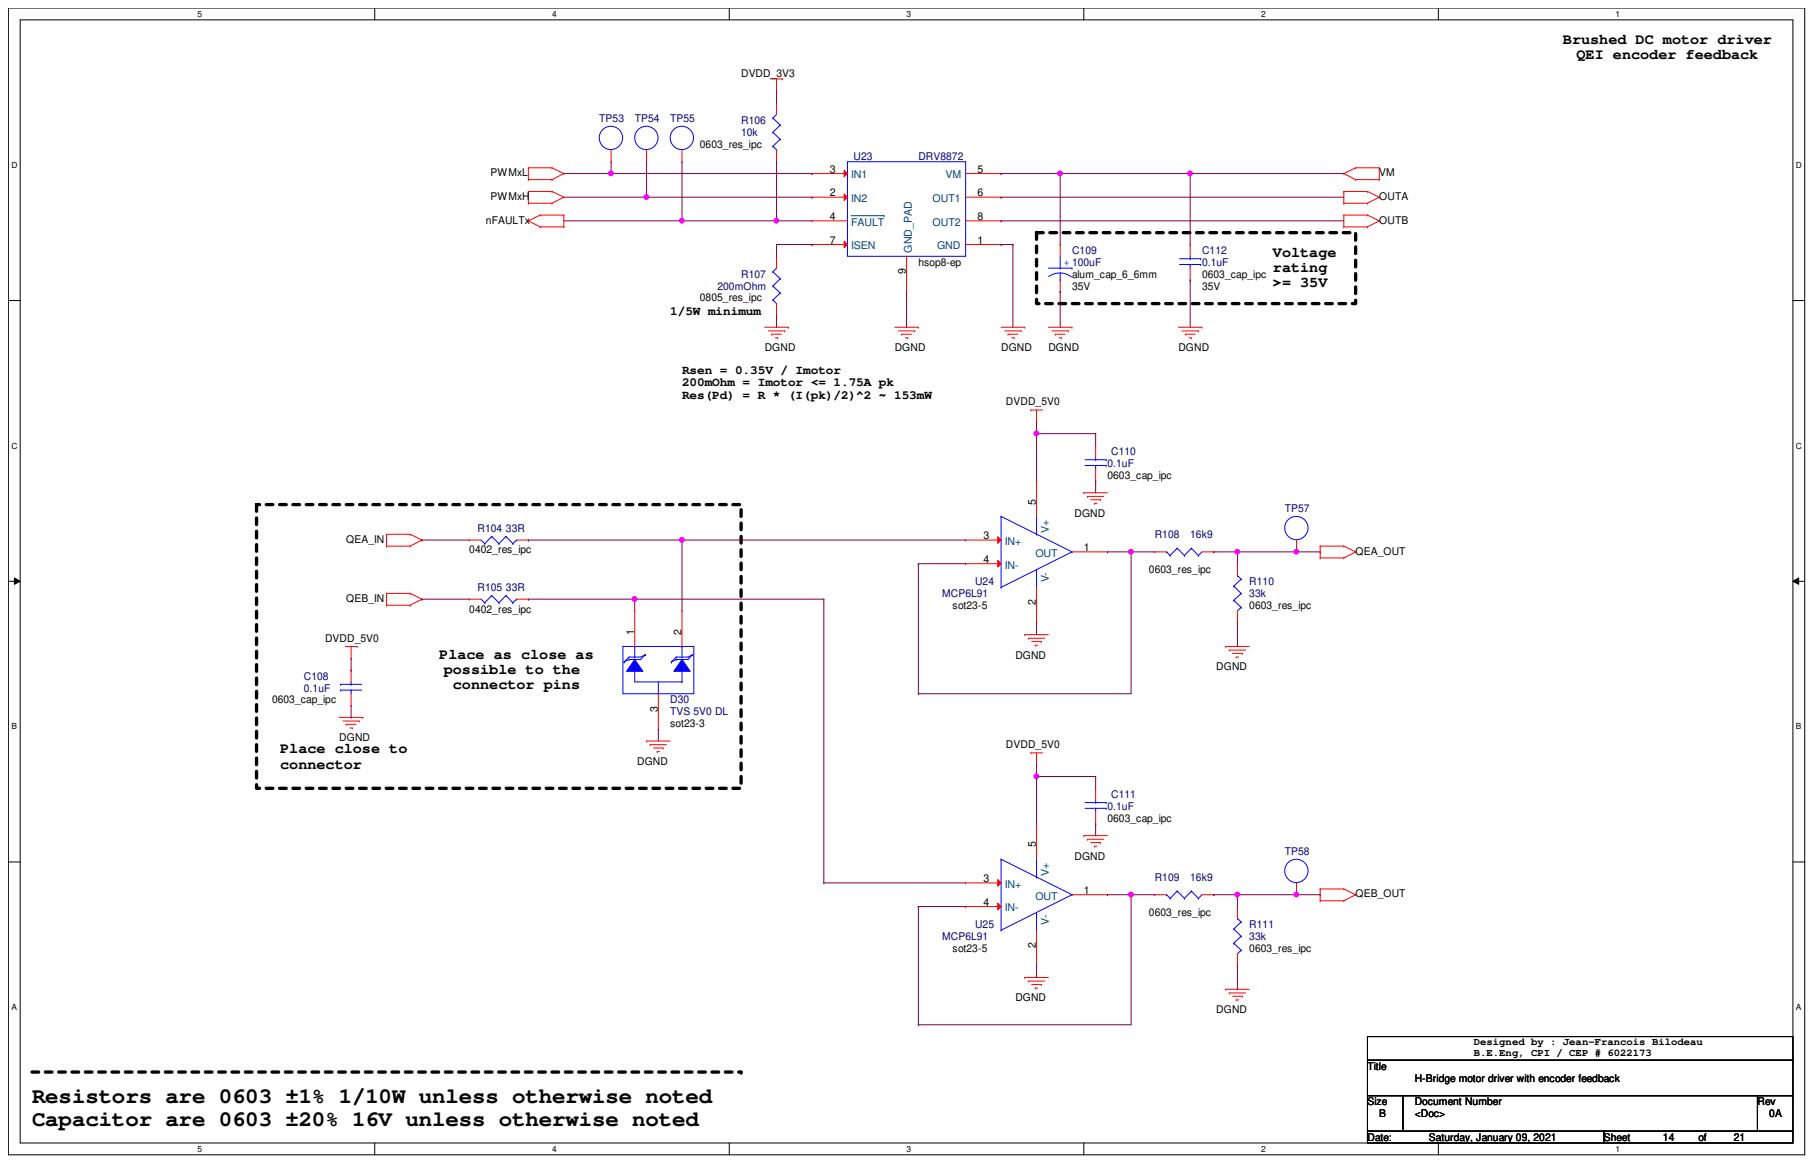
[picture p26: page 14]

Brushed DC motor driver
QEI encoder feedback

Place as close as
possible to the
connector pins

Designed by : Jean-Francois Bilodeau
B.E.Eng, CPI / CEP # 6022173

H-Bridge motor driver with encoder feedback

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

### Voltage rating

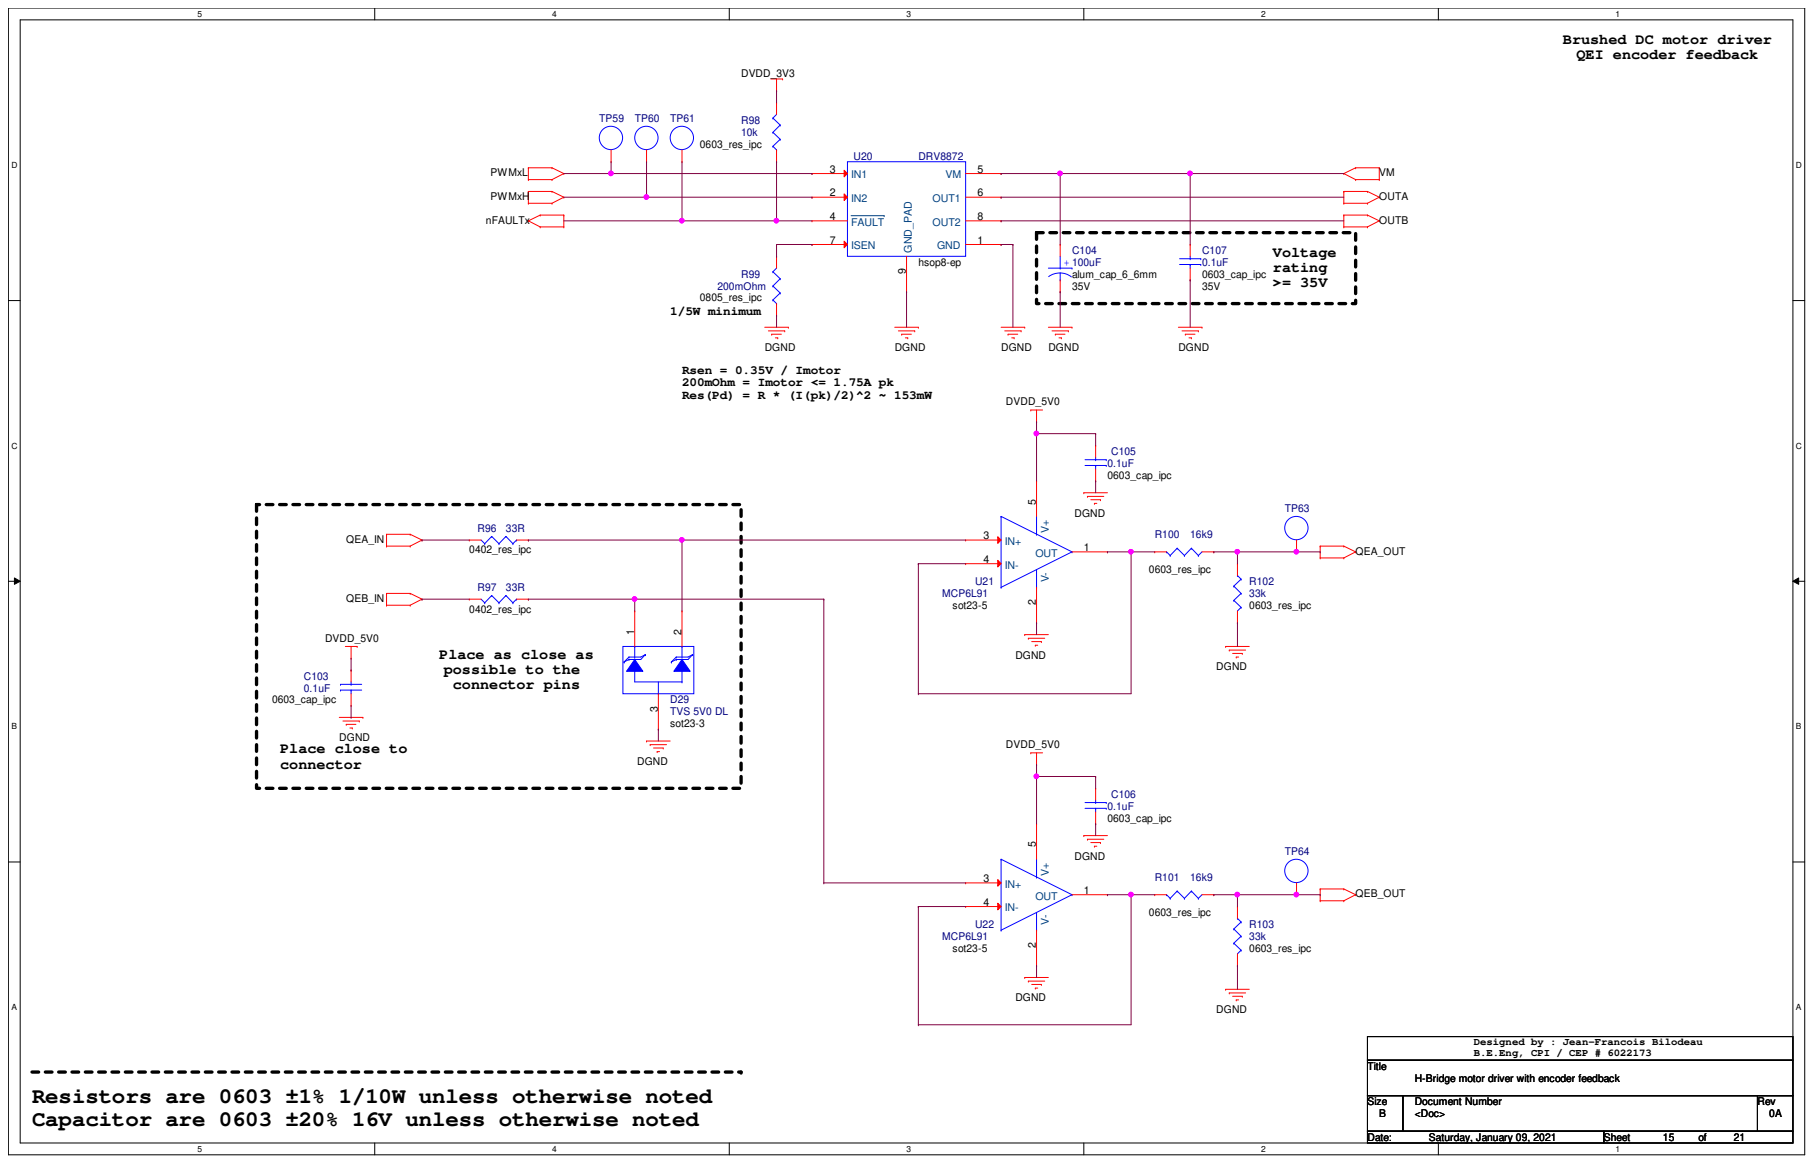
[picture p27: page 15]

Brushed DC motor driver
QEI encoder feedback

Place as close as
possible to the
connector pins

Designed by : Jean-Francois Bilodeau
B.E.Eng, CPI / CEP # 6022173

H-Bridge motor driver with encoder feedback

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

### <= 0.5% tolerance

## Vin = 12V

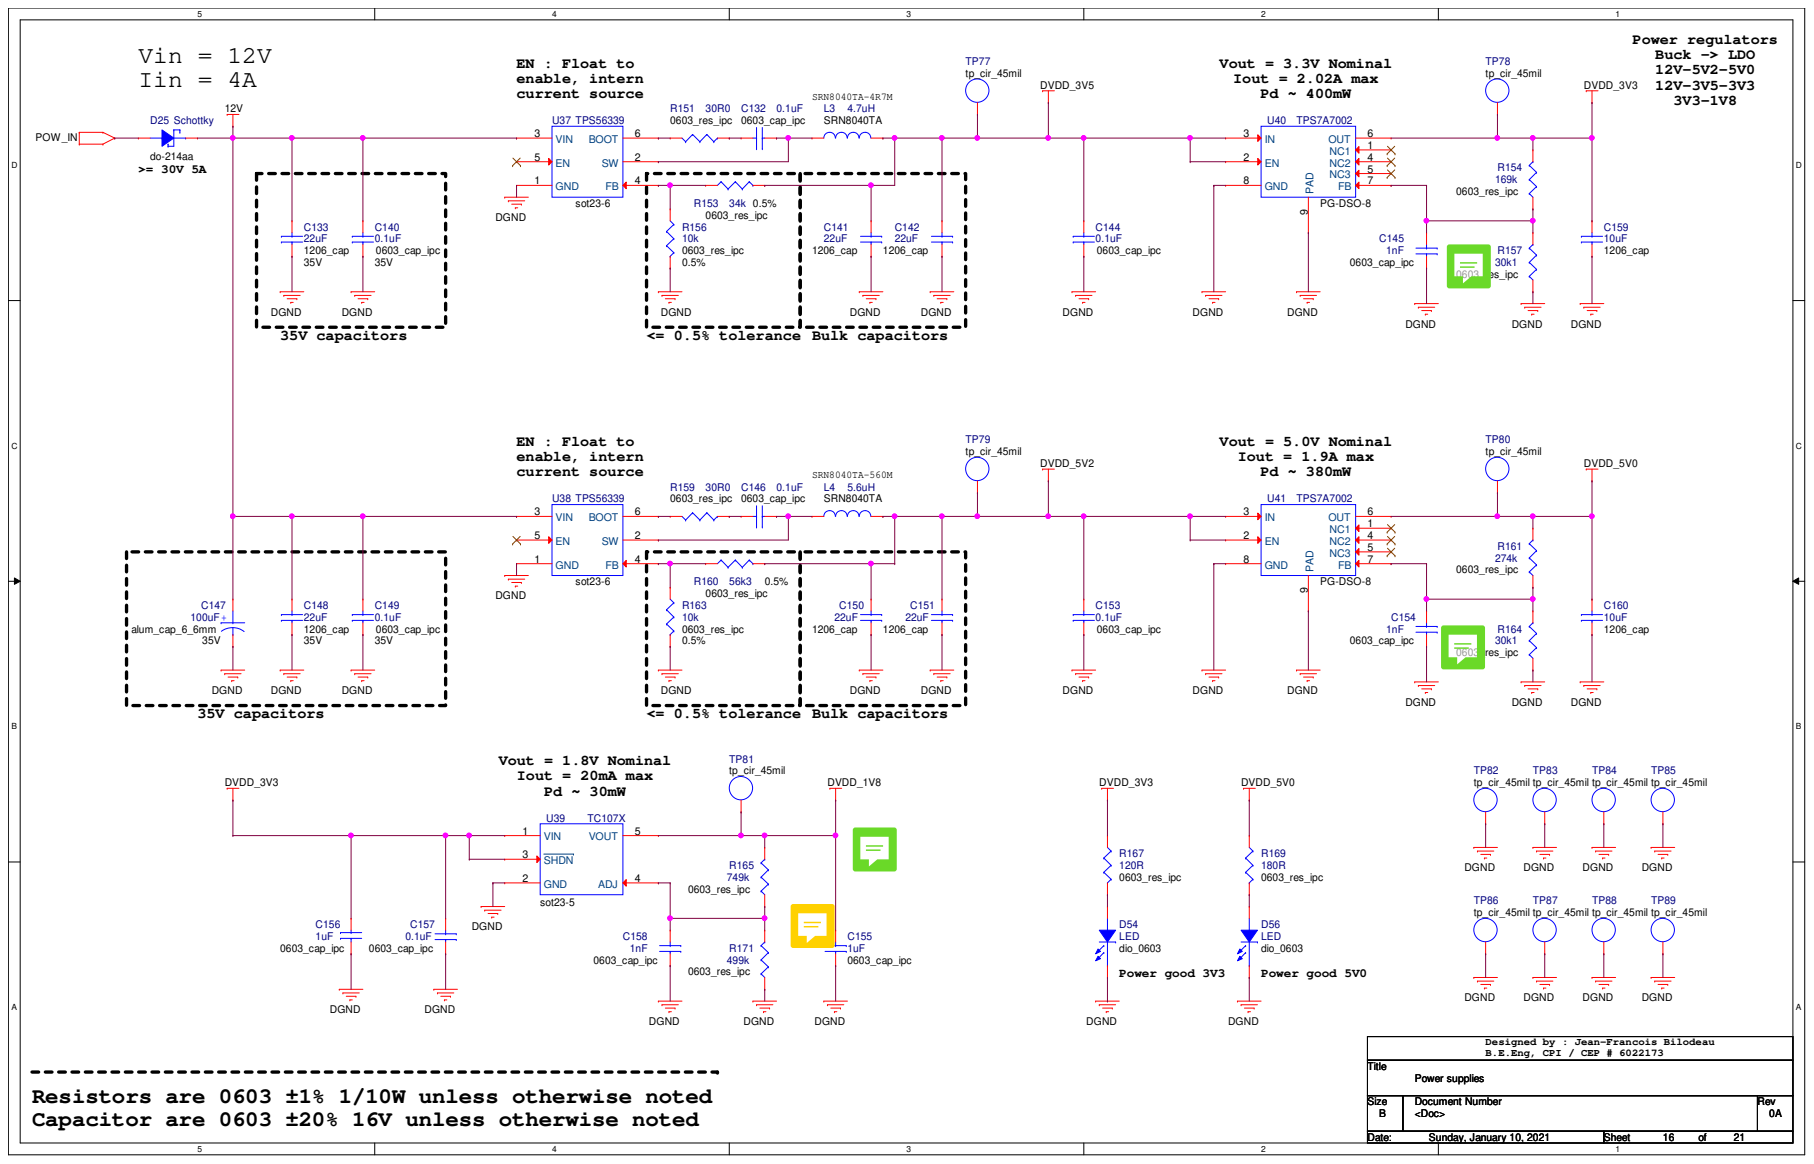
[picture p28: page 16]

Designed by : Jean-Francois Bilodeau
B.E.Eng, CPI / CEP # 6022173

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

D D

# Riverdi EVE TFT

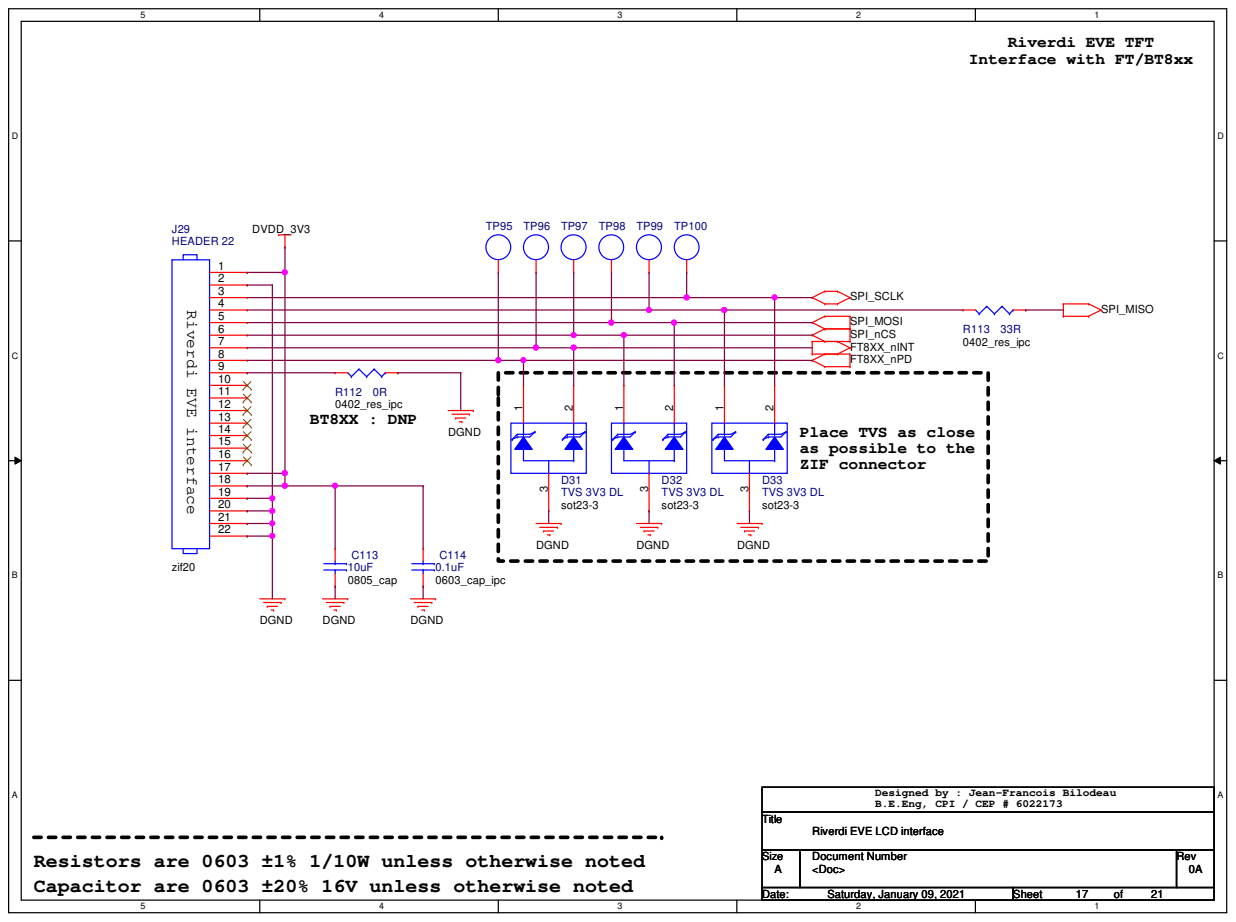
[picture p29: page 17]

Riverdi EVE interface Place TVS as close as possible to the ZIF connector

Designed by : Jean-Francois Bilodeau
B.E.Eng, CPI / CEP # 6022173

Riverdi EVE LCD interface

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

D D

# As close as possible

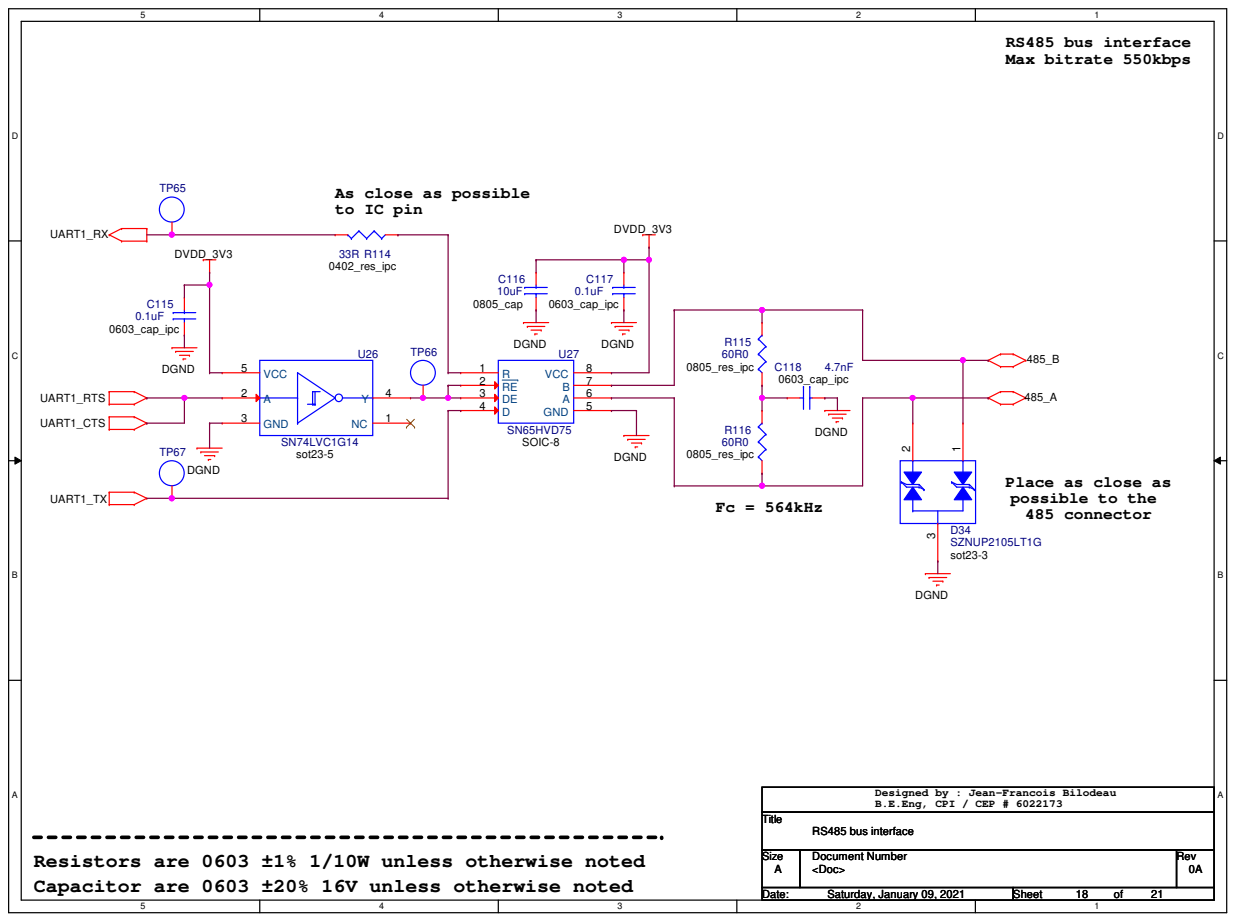
[picture p30: page 18]

Place as close as
possible to the
485 connector

Designed by : Jean-Francois Bilodeau
B.E.Eng, CPI / CEP # 6022173

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

### R/C DAC output 2x Servo-motor PWM 3x

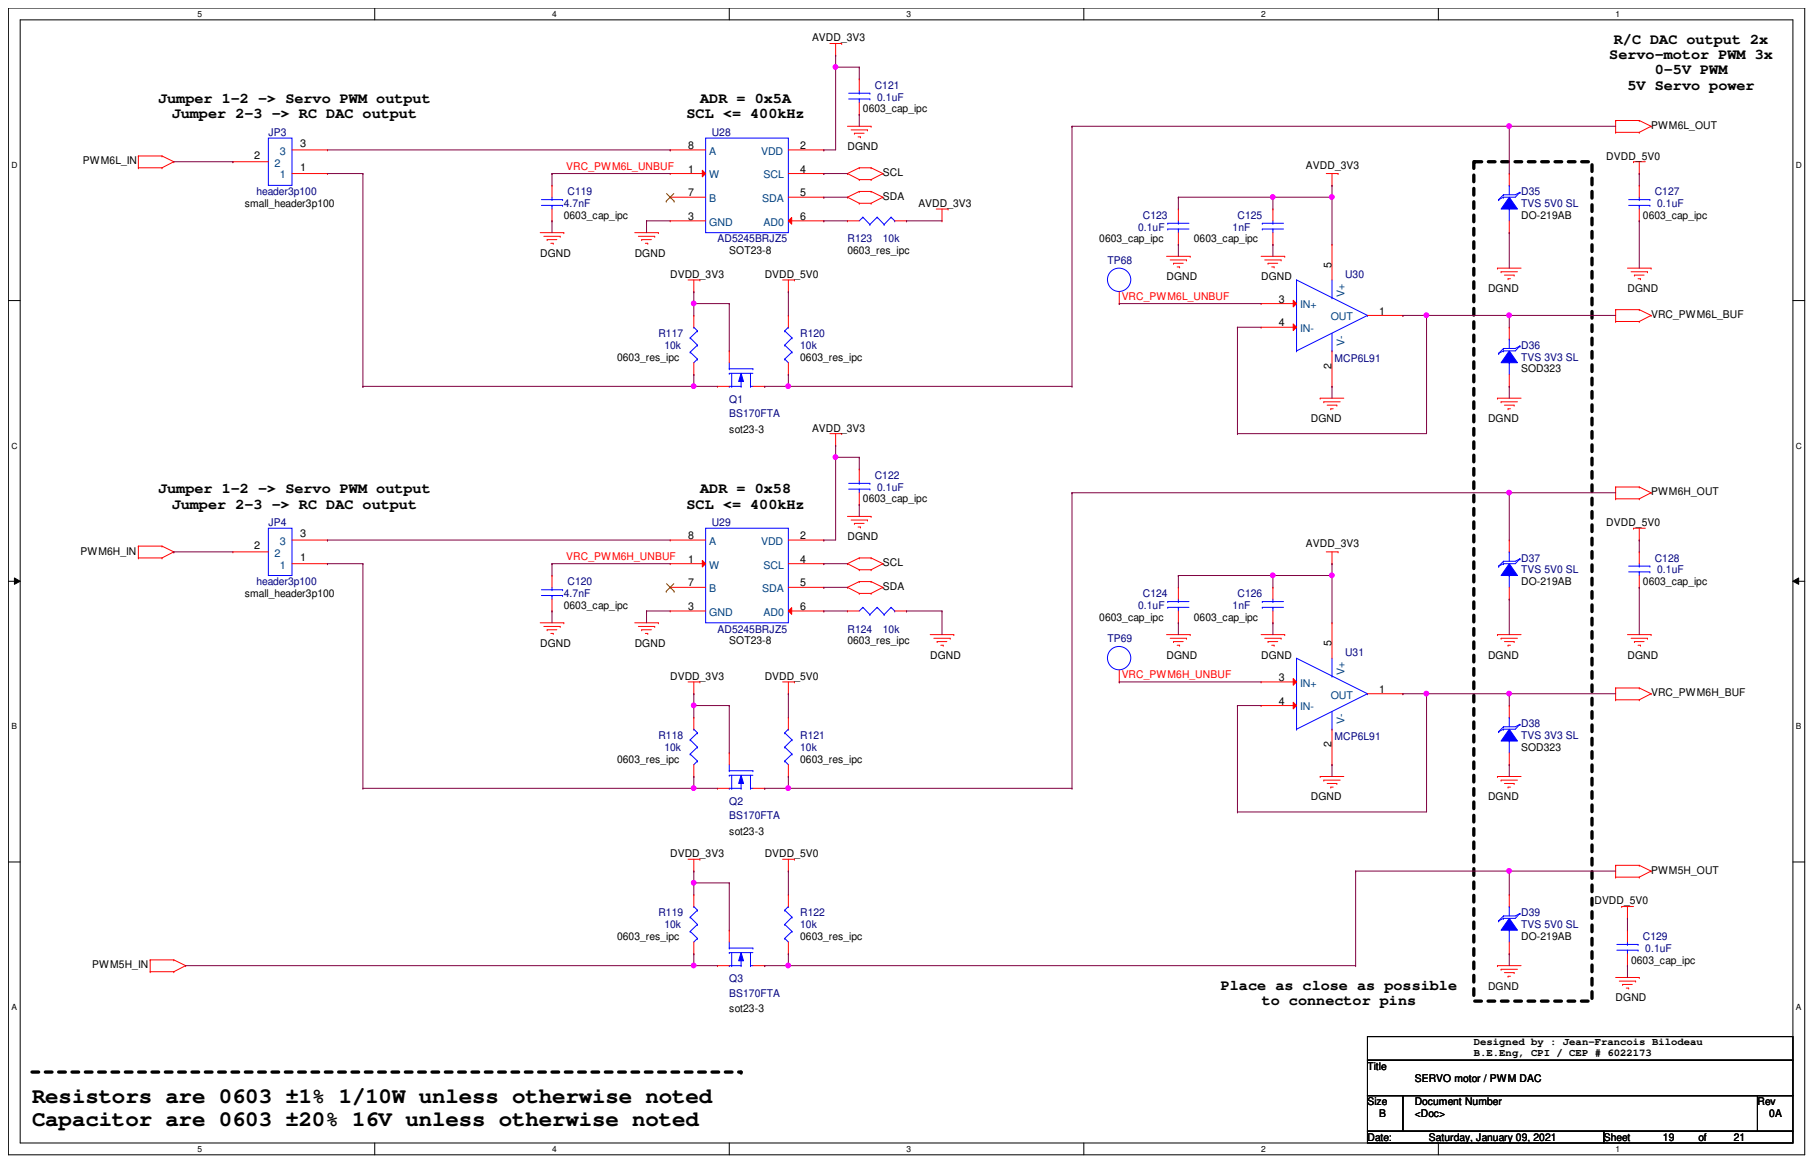
[picture p31: page 19]

Jumper 1-2 -> Servo PWM output
Jumper 2-3 -> RC DAC output

Place as close as possible

Designed by : Jean-Francois Bilodeau
B.E.Eng, CPI / CEP # 6022173

SERVO motor / PWM DAC

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

D D

# USB-UART Converter

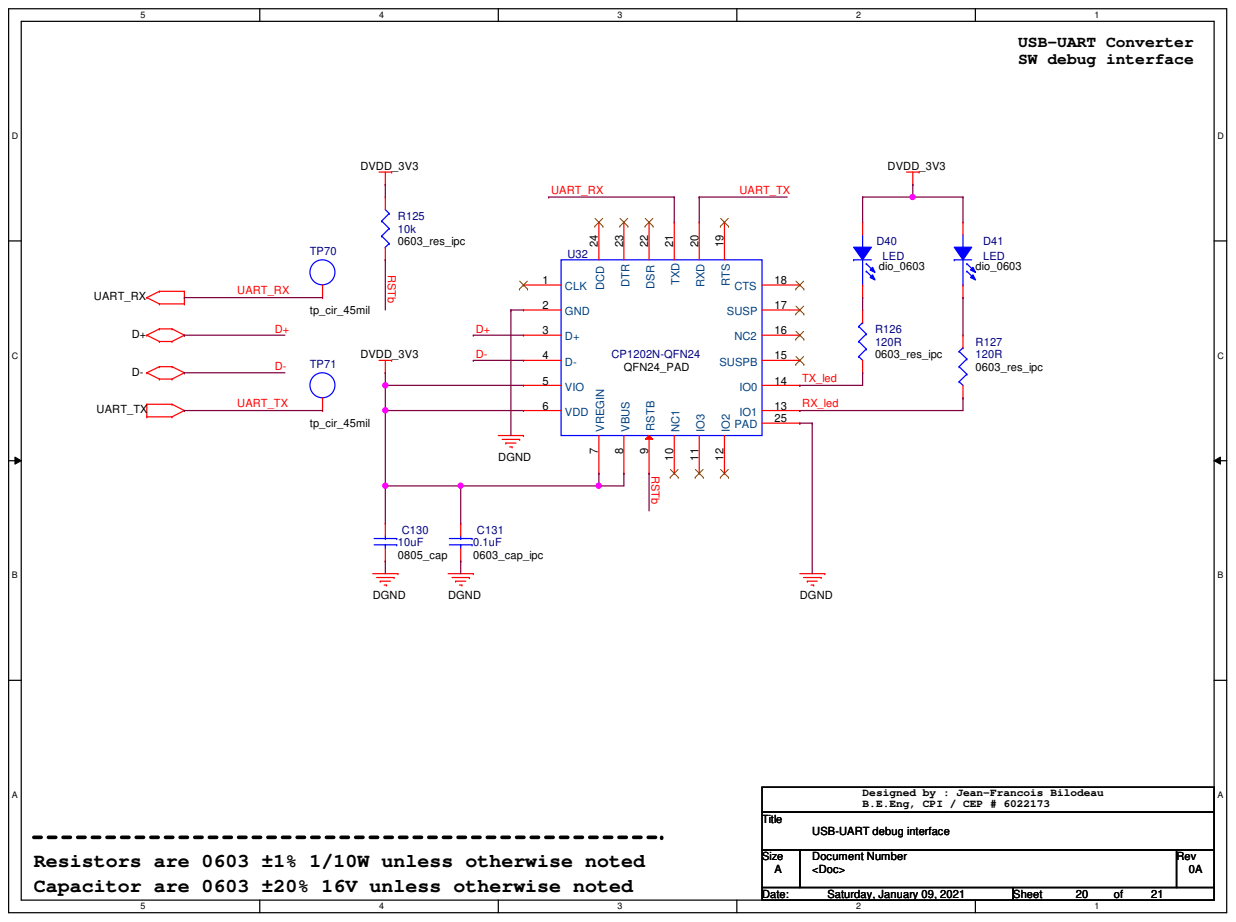
[picture p32: page 20]

Designed by : Jean-Francois Bilodeau
B.E.Eng, CPI / CEP # 6022173

USB-UART debug interface

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

### General purpose I/O

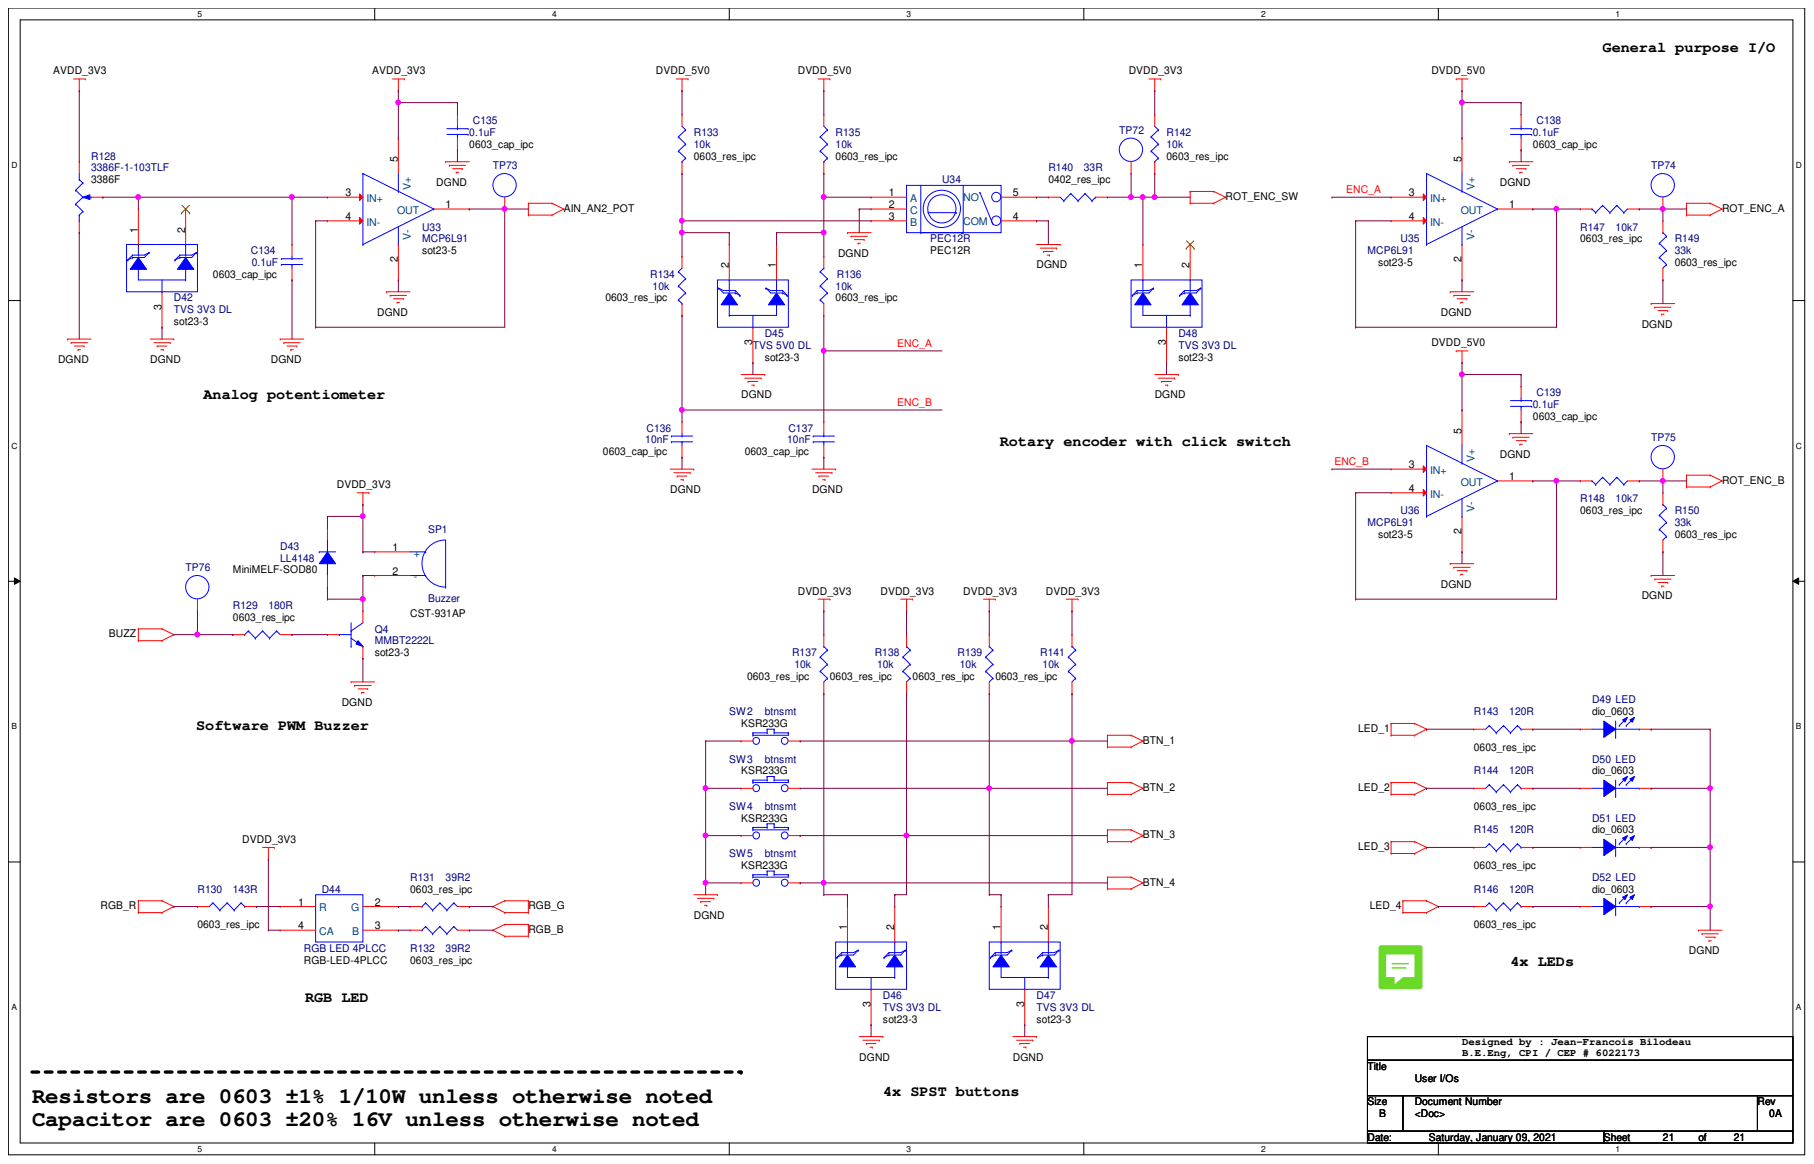
[picture p33: page 21]

Rotary encoder with click switch

Designed by : Jean-Francois Bilodeau
B.E.Eng, CPI / CEP # 6022173

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
