lecejeff/dsPeak/Hardware/v1_00-0a/schema_pdf/dsPeak-v1_00-0a-_PCB.pdf

# ART FILM - TOP

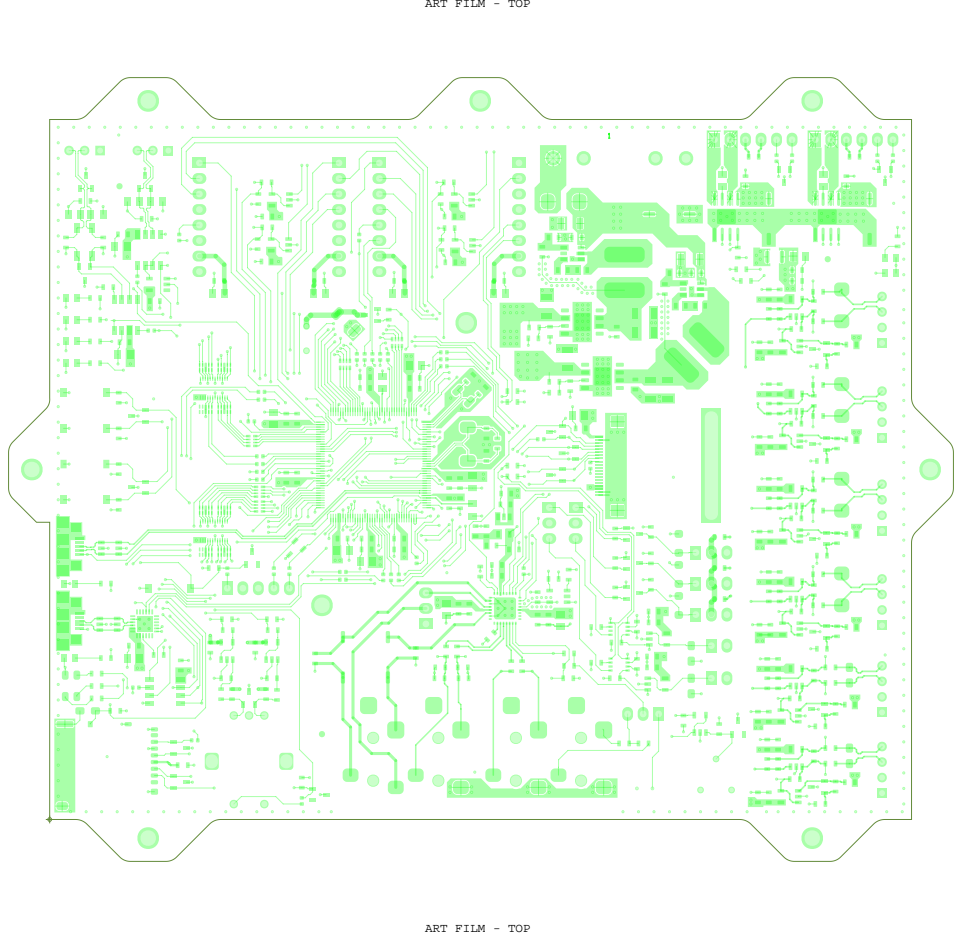
[picture p34: page 1]

ART FILM - TOP

# ART FILM - INNER1

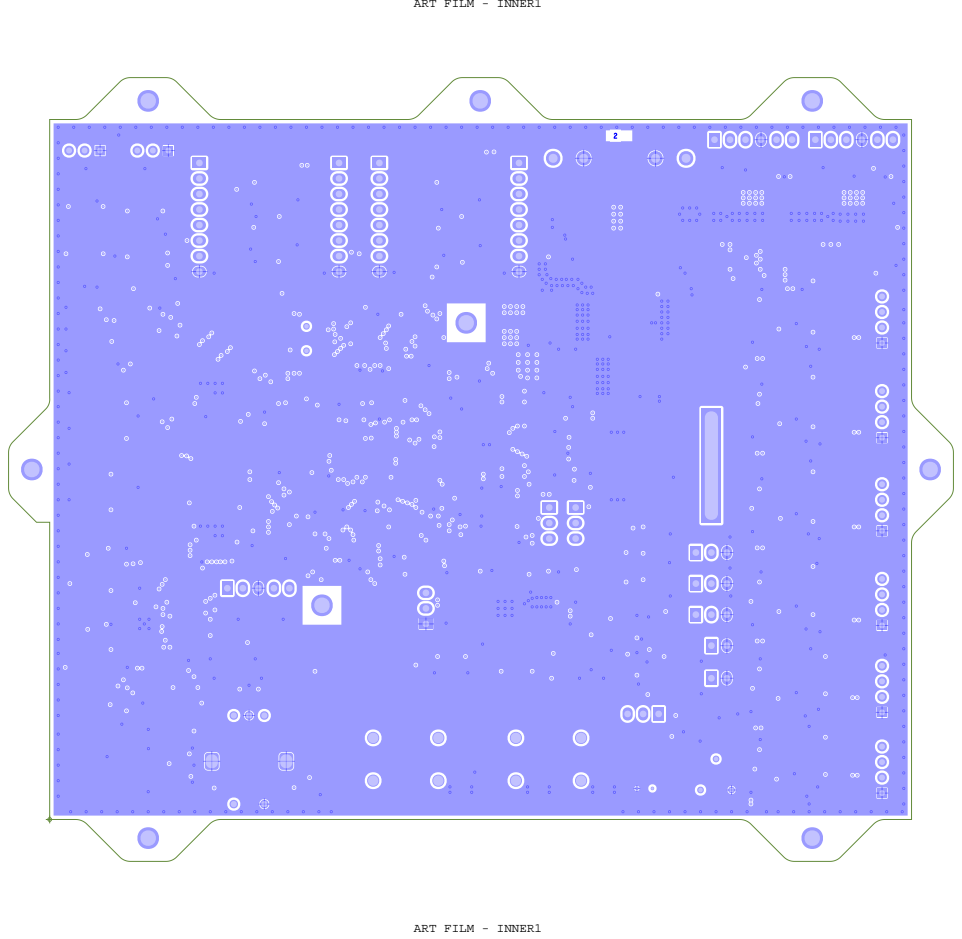
[picture p35: page 2]
ART FILM - INNER1

# ART FILM - INNER2

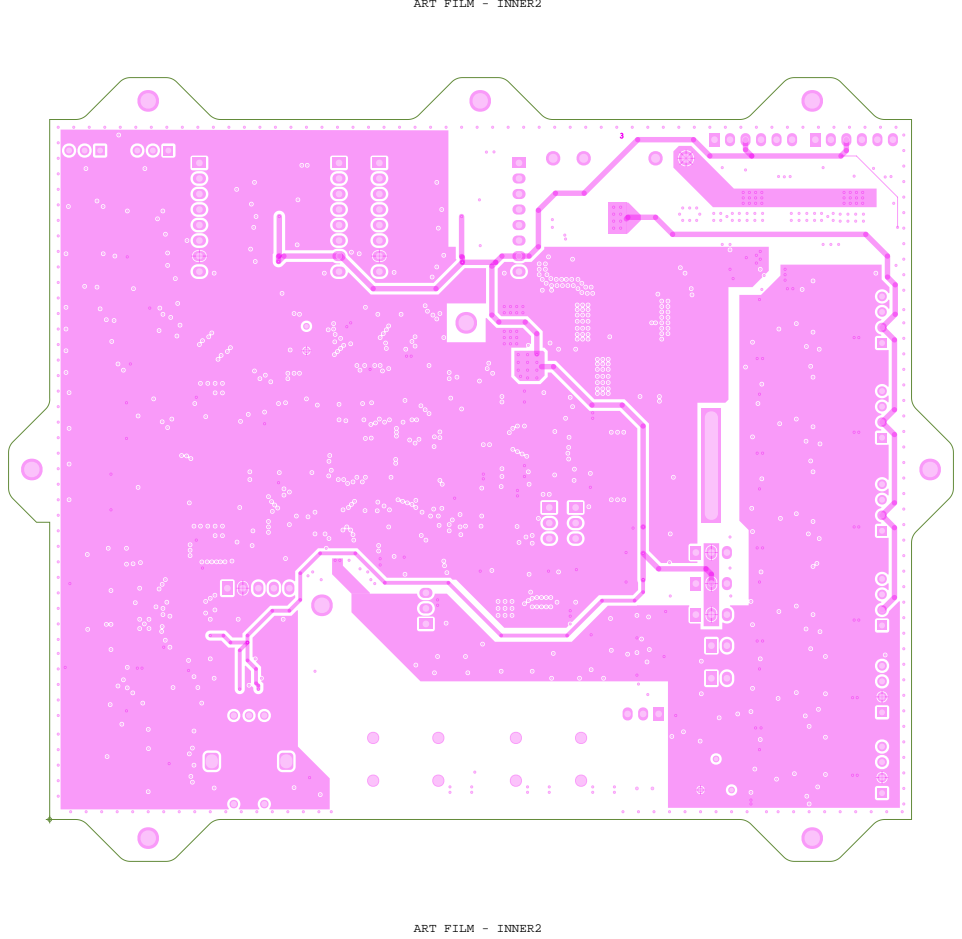
[picture p36: page 3]
ART FILM - INNER2

# ART FILM - BOTTOM

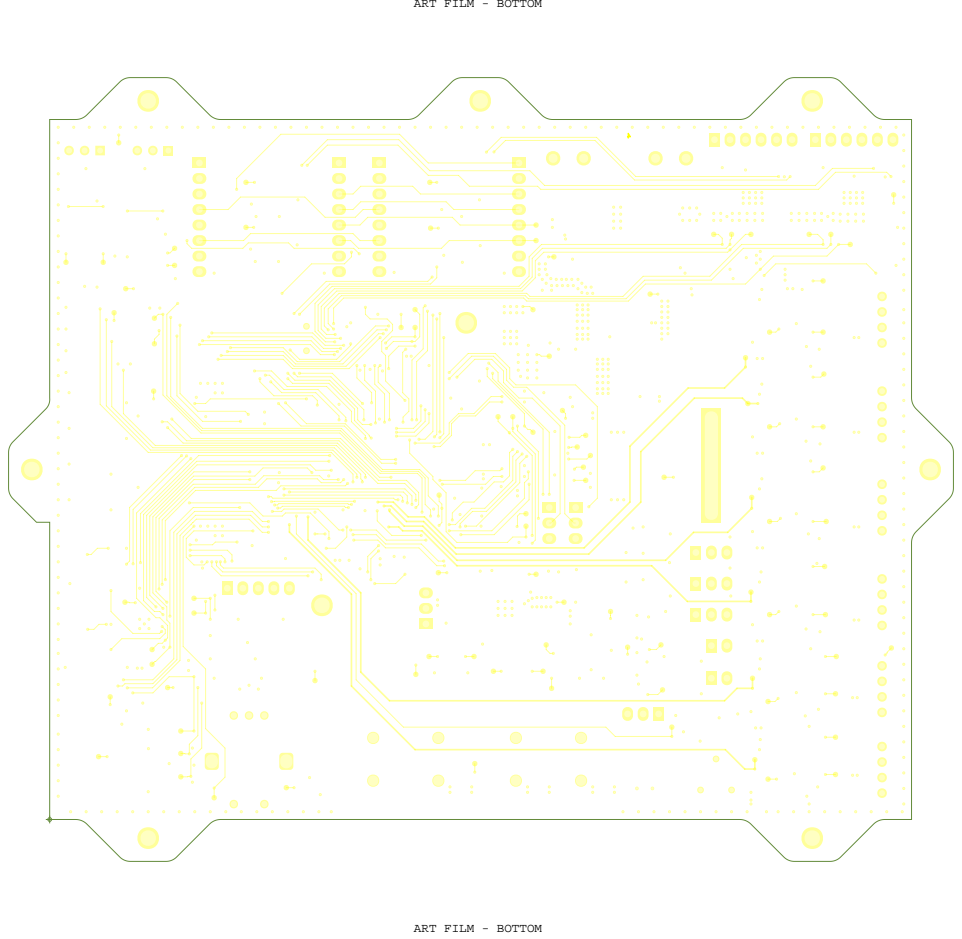
[picture p37: page 4]

ART FILM - BOTTOM

# ART FILM - SoldermaskTop

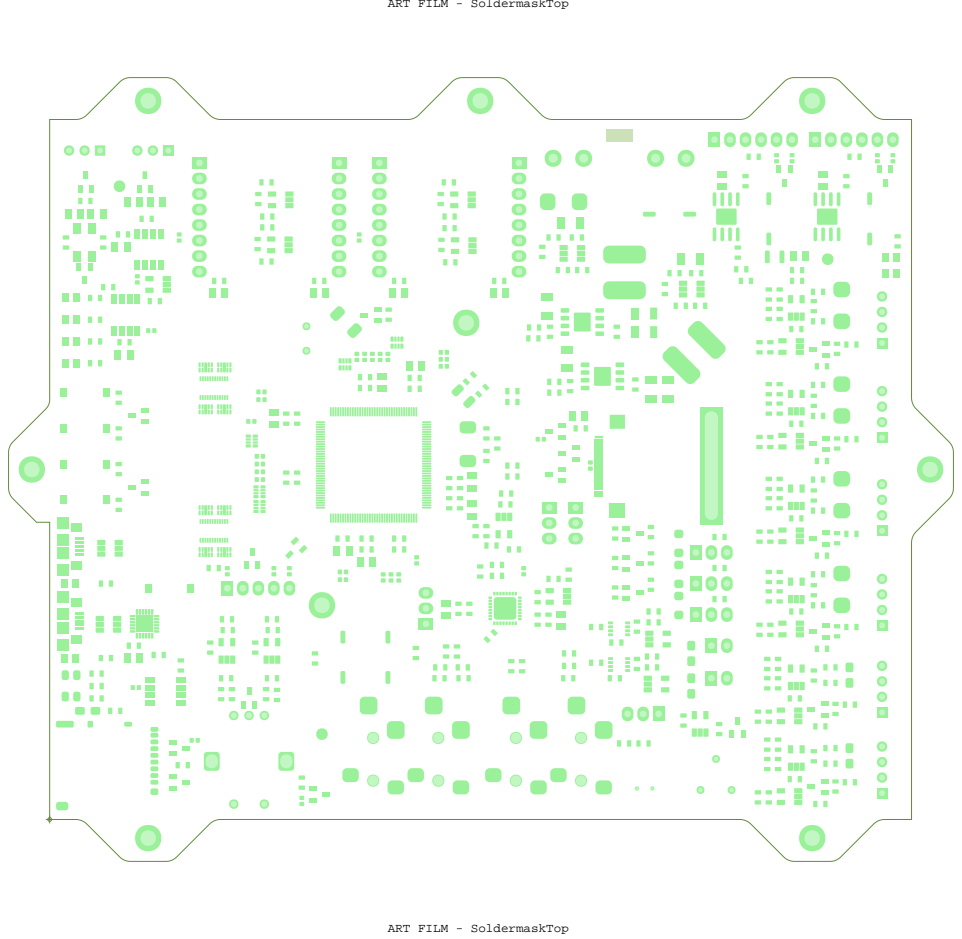
[picture p38: page 5]

ART FILM - SoldermaskTop

# ART FILM - SoldermaskBot

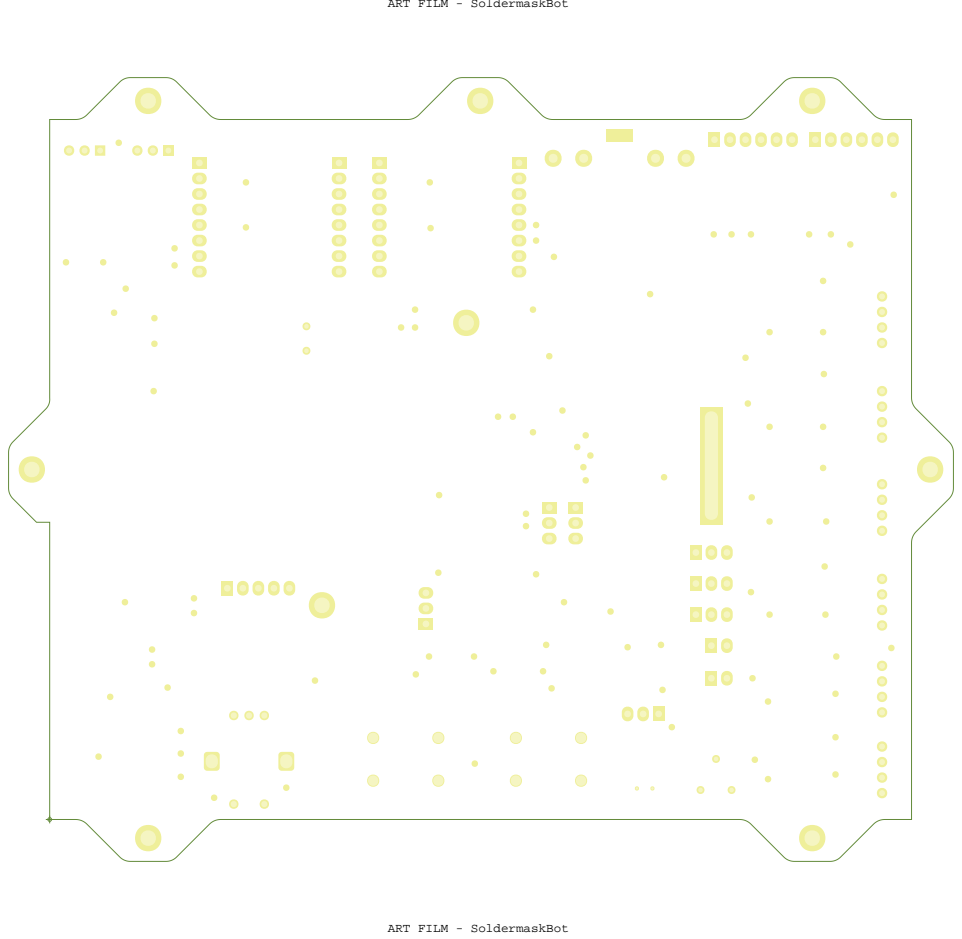
[picture p39: page 6]

ART FILM - SoldermaskBot

# ART FILM - SilkscreenTop

AN

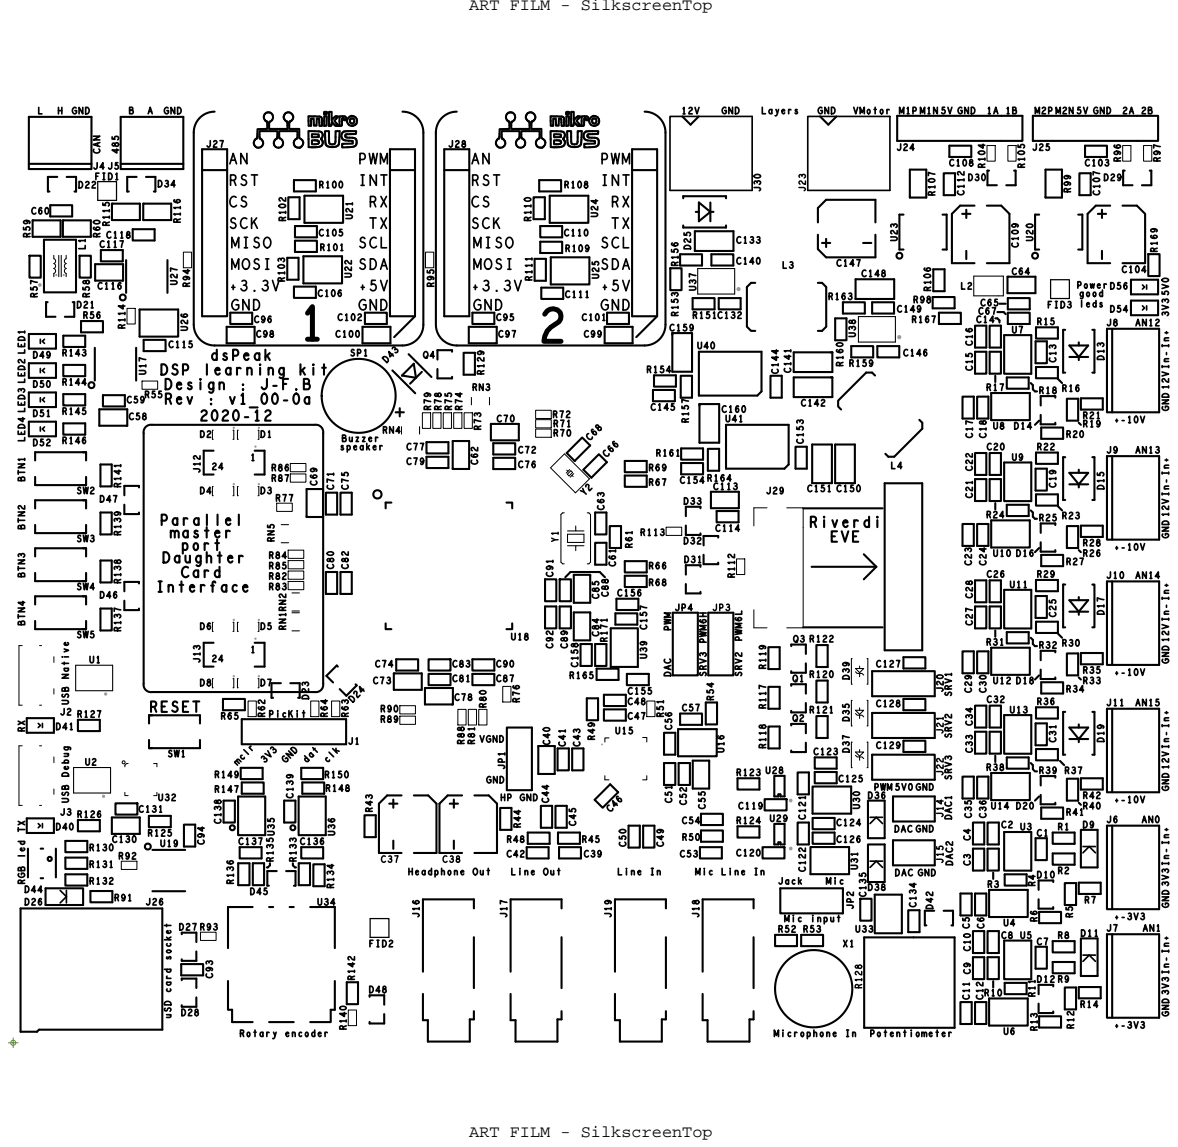
[picture p40: page 7]

GND 3V3 In- In+ GND 12V In- In+ GND 12V In- In+

USB Native USB Debug

# ART FILM - SilkscreenBot

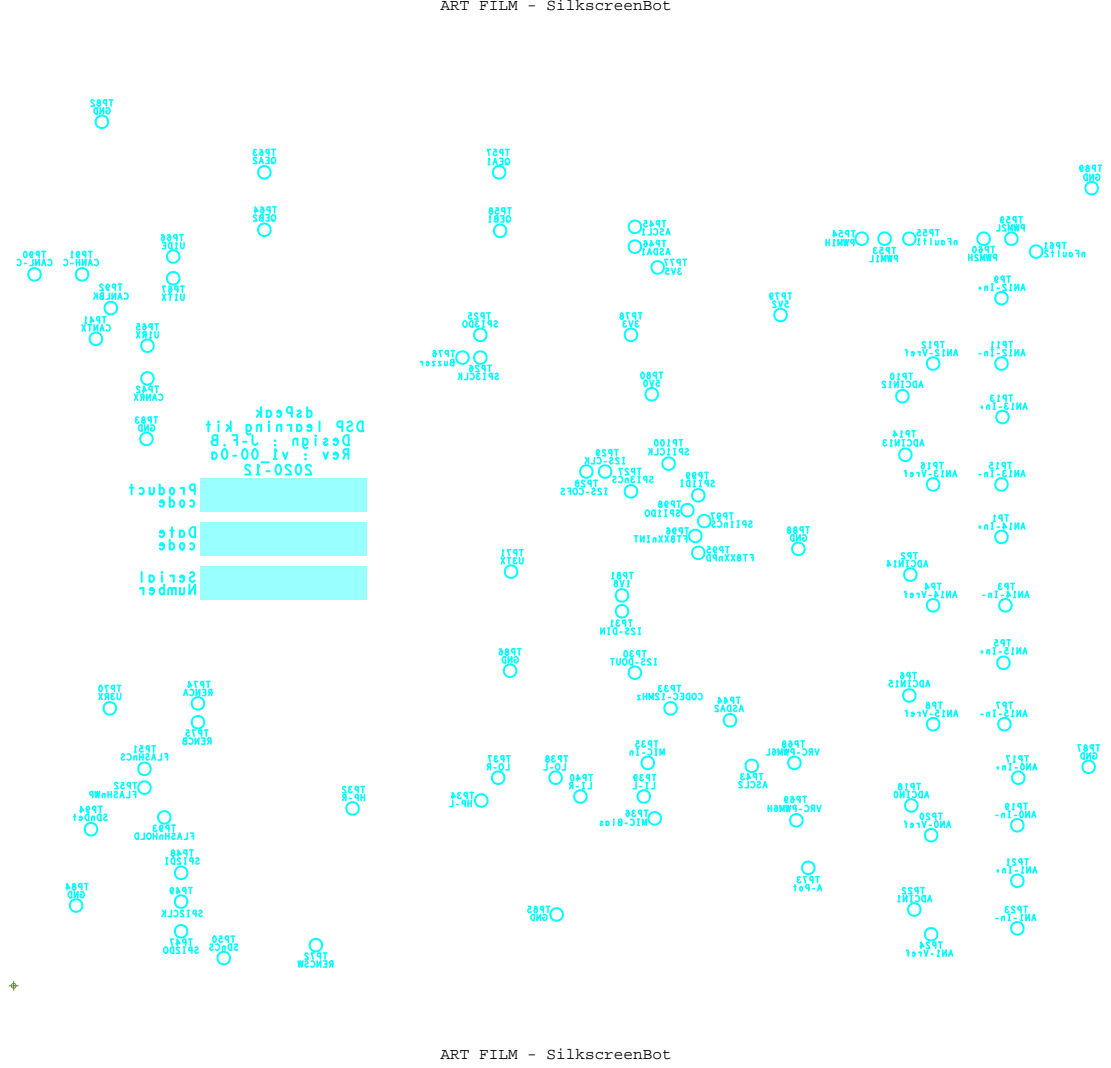
[picture p41: page 8]

# ART FILM - Outline

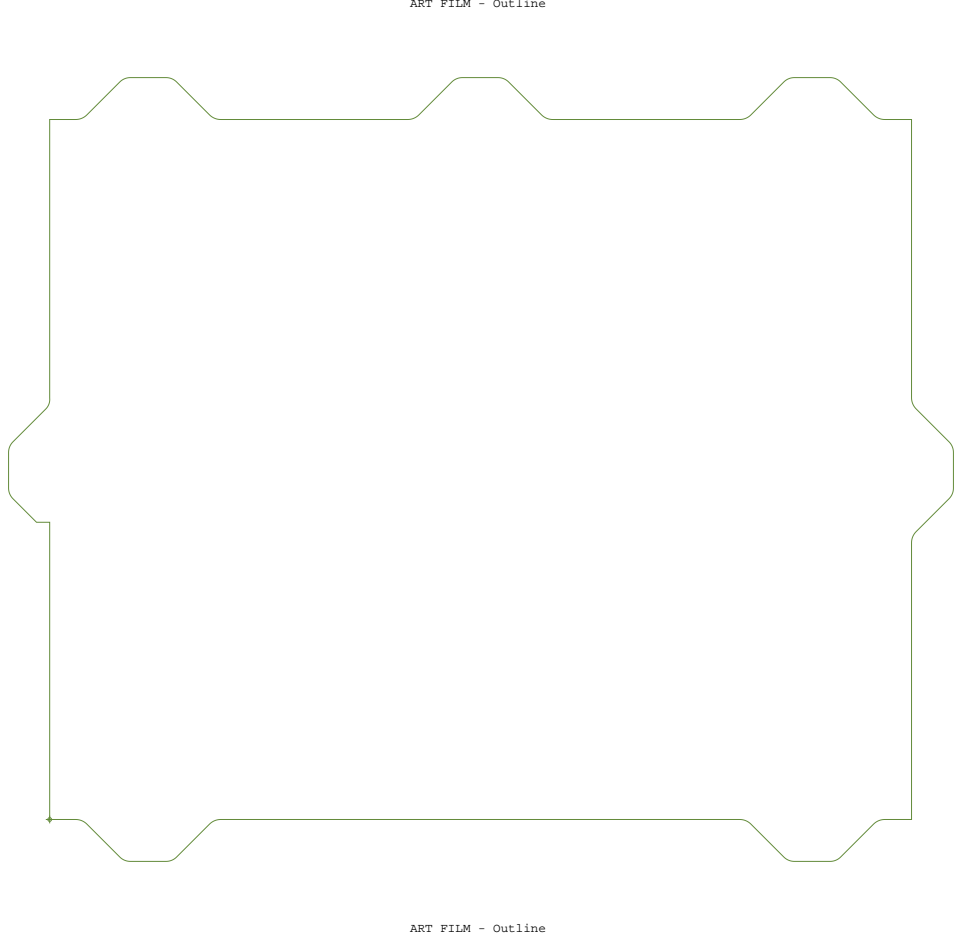
[picture p42: page 9]

ART FILM - Outline
