lecejeff/dsPeak/Hardware/Daughter Card/v1_00-0a/schema_pdf/daughter_card-v1_00-0a-SCH.pdf

### TFT LCD 0.96"

### 8-bit parallel

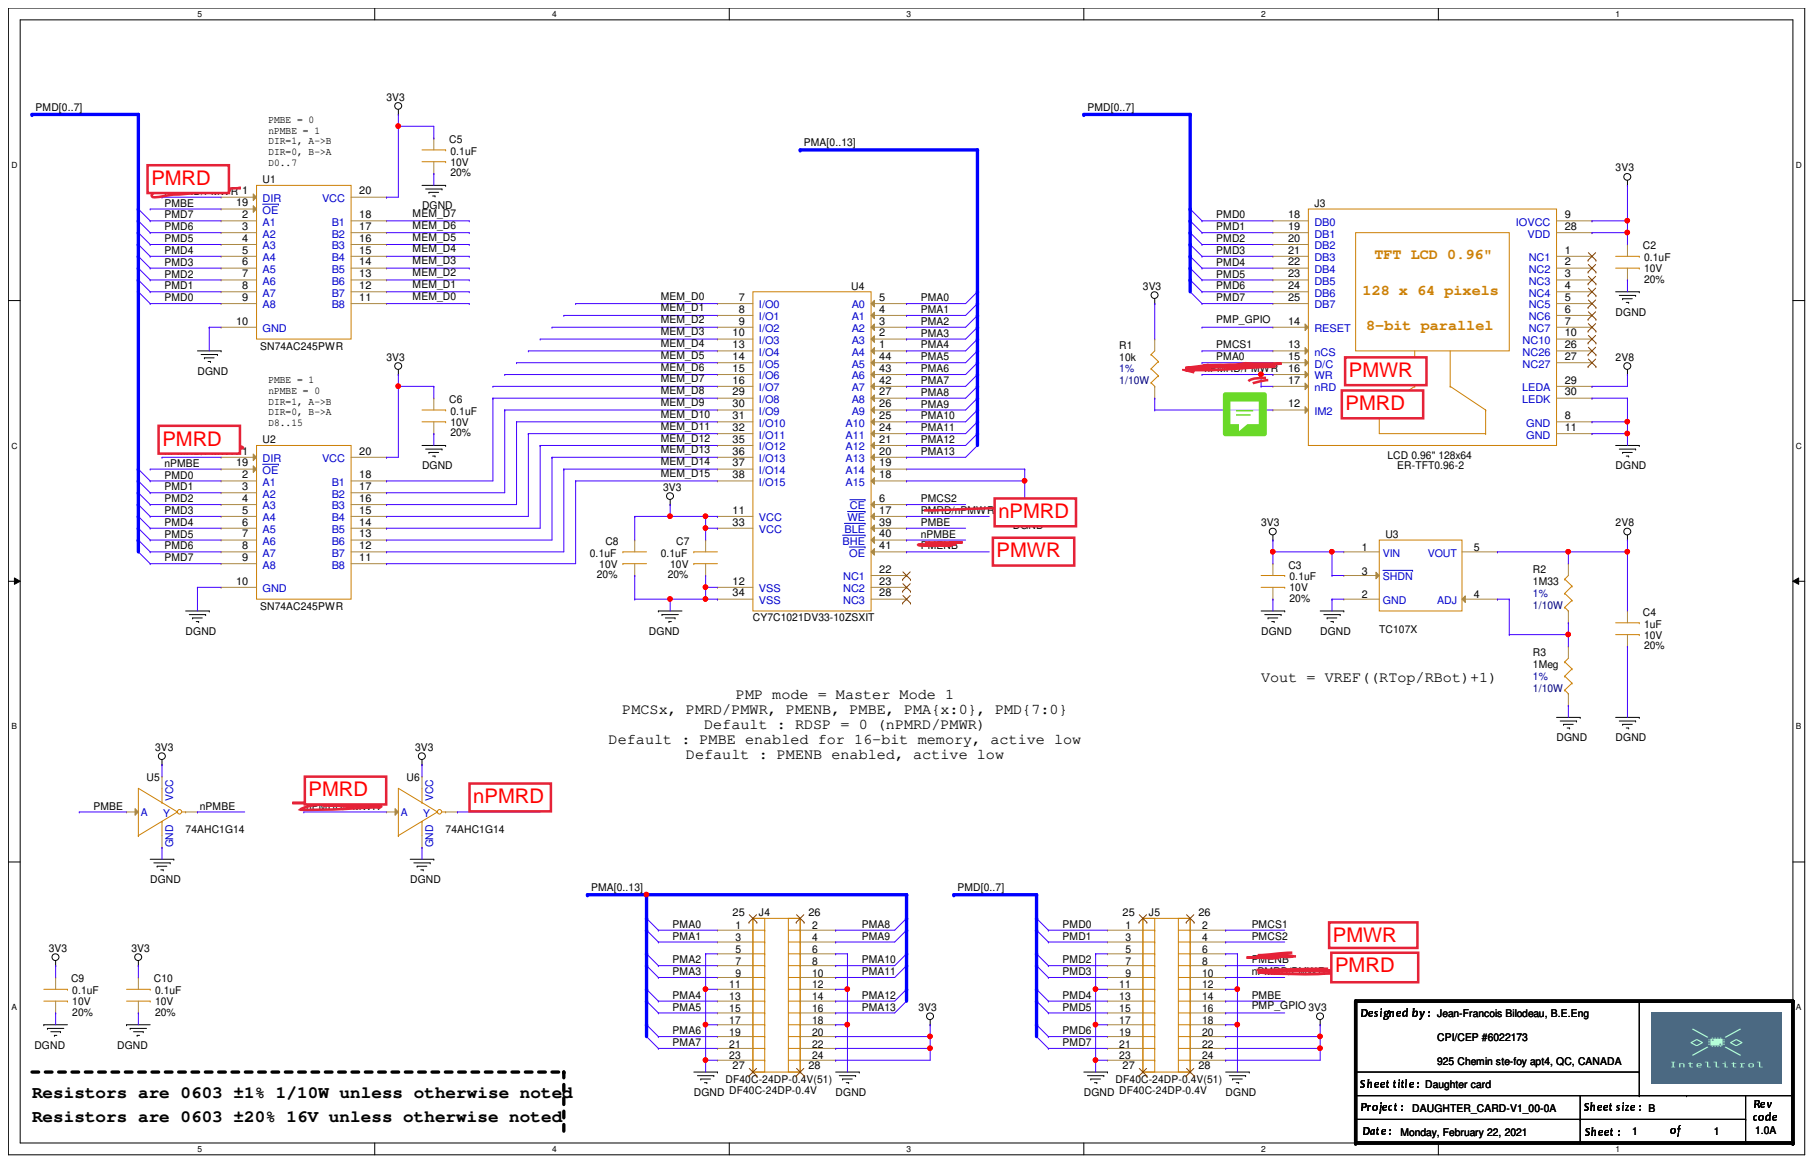
[picture p43: page 1]

Vout = VREF((RTop/RBot)+1)

PMP mode = Master Mode 1

PMCSx, PMRD/PMWR, PMENB, PMBE, PMA{x:0}, PMD{7:0}

Default : RDSP = 0 (nPMRD/PMWR)

Default : PMBE enabled for 16-bit memory, active low

Default : PMENB enabled, active low

925 Chemin ste-foy apt4, QC, CANADA

Resistors are 0603 ±1% 1/10W unless otherwise noted
Resistors are 0603 ±20% 16V unless otherwise noted

---DAUGHTER_CARD-V1_00-0A DAUGHTER_CARD-V1_00-0A       DAUGHTER_CARD-V1_00-0A | ---   ------   B B B | ---  - --1.0A 1.0A 1.0A

 - - -   Monday, February 22, 2021 Monday, February 22, 2021 Monday, February 22, 2021 |          ------1 1 1 1 1 1
