lecejeff/dsPeak/Hardware/Daughter Card/v1_00-0a/schema_pdf/Daughter_card-v1_00-0a-PCB.pdf

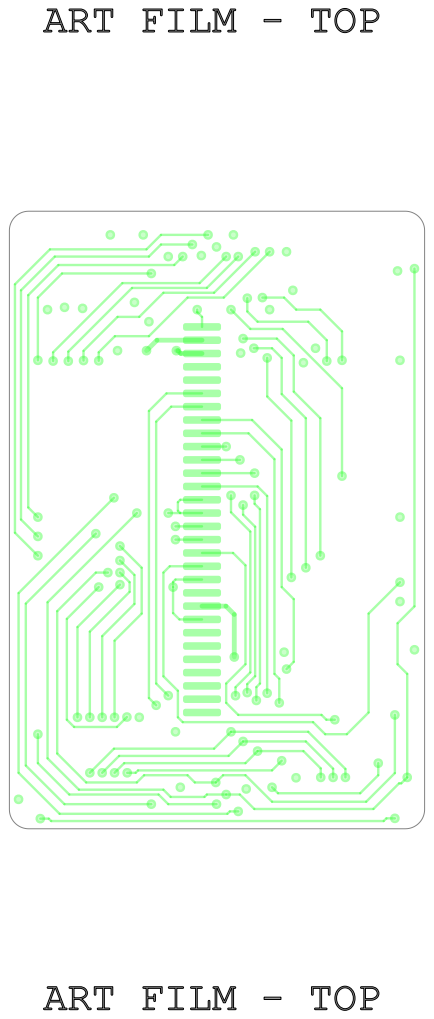
[picture p44: page 1]

ART FILM - TOP

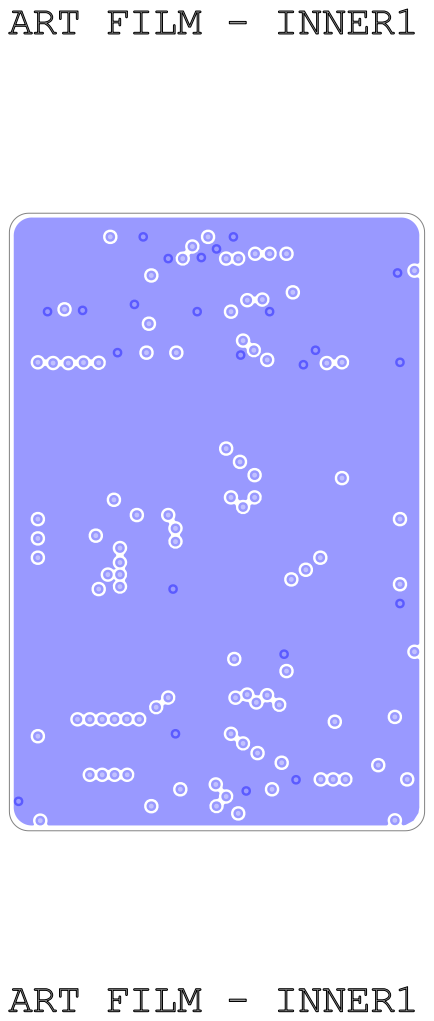
[picture p45: page 2]
ART FILM - INNER1

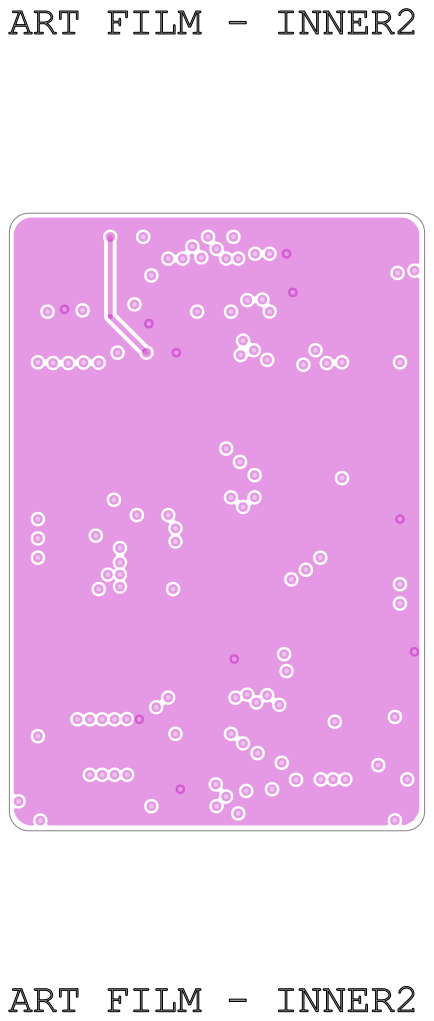
[picture p46: page 3]
ART FILM - INNER2

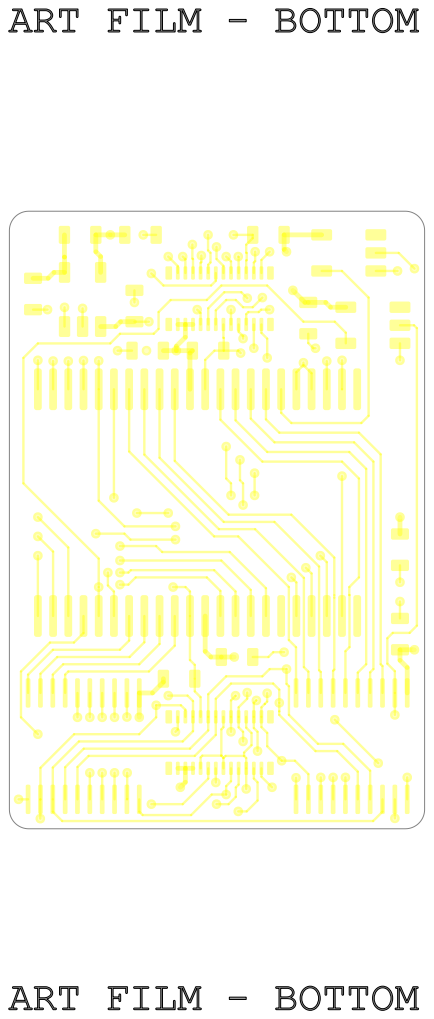
[picture p47: page 4]

ART FILM - BOTTOM

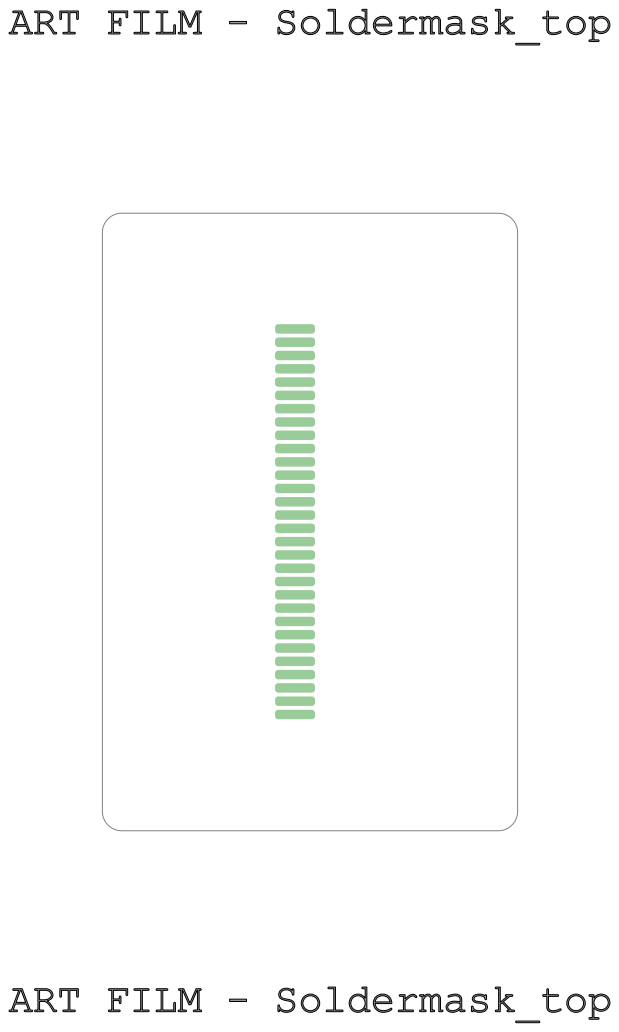
[picture p48: page 5]
ART FILM - Soldermask_top

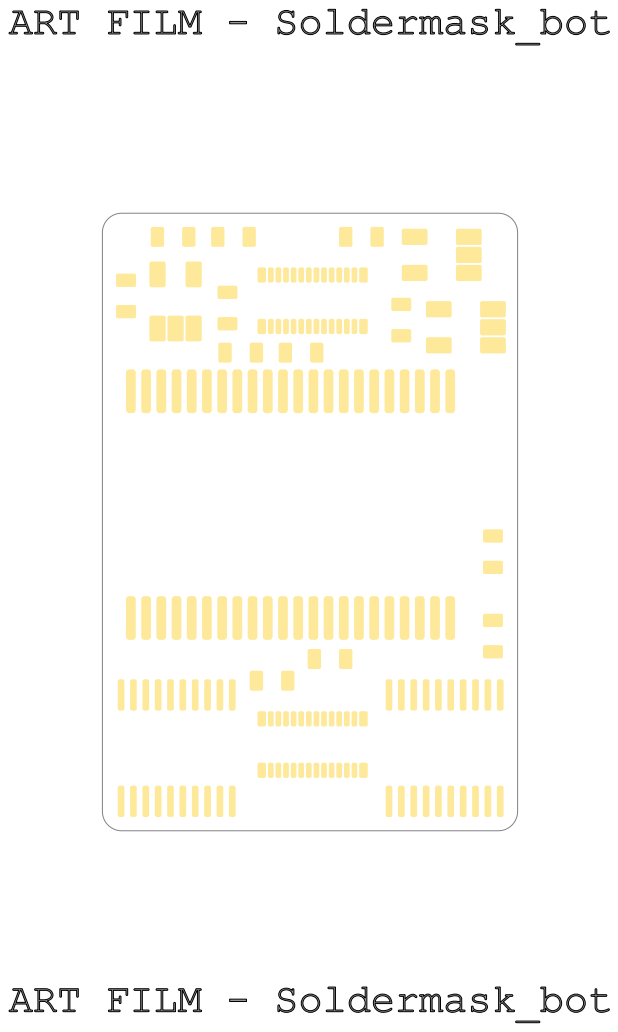
[picture p49: page 6]
ART FILM - Soldermask_bot

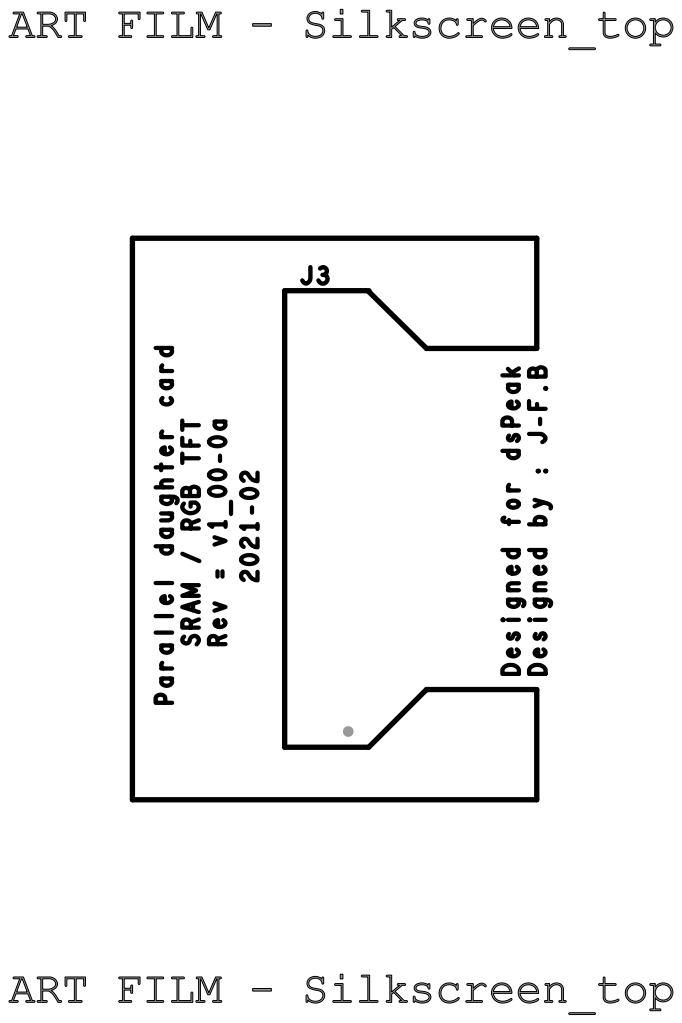
[picture p50: page 7]
ART FILM - Silkscreen_top; ART FILM - Silkscreen_top Parallel daughter card SRAM / RGB TFT Rev = v1_00-0a; Designed by : J-F.B

Designed for dsPeak

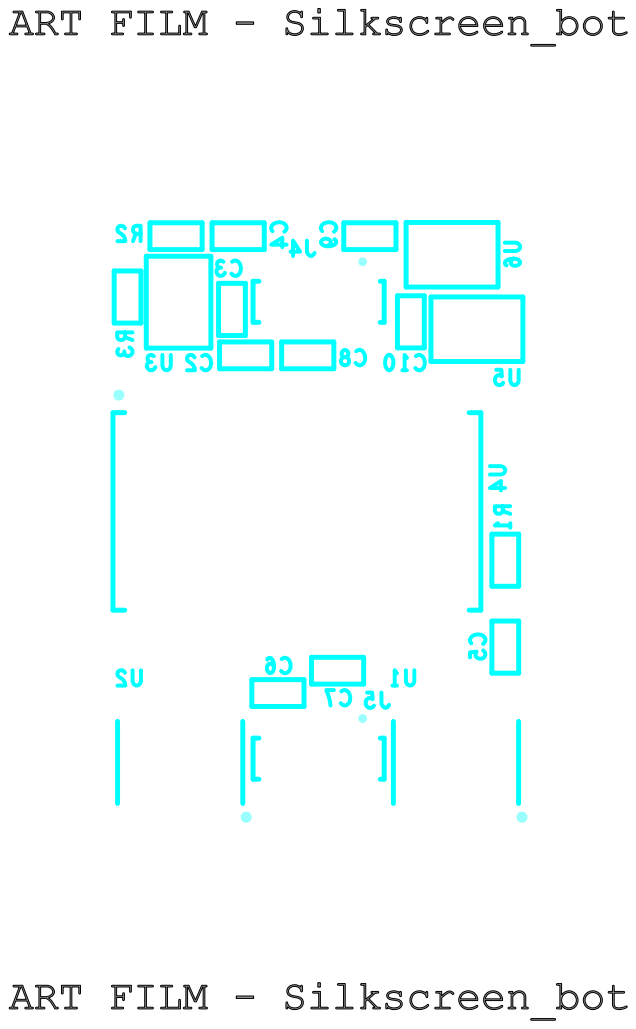
[picture p51: page 8]
ART FILM - Silkscreen_bot

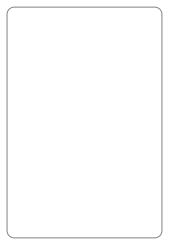
[picture p52: figure]

ART FILM - Outline

ART FILM - Outline
