lecejeff/dsPeak/(list of files, drawings)

Other design files:
Hardware/Daughter Card/v1_00-0a/capture/DAUGHTER_CARD-V1_00-0A.DSN
Hardware/Daughter Card/v1_00-0a/capture/Daughter_Card-v1_00-0a.opj
Hardware/v1_00-0b/capture/DSPEAK-V1_00-0B.opj
