lecejeff/dsPeak/Software/dsPeak library/src/DMA.c

#include "DMA.h"
STRUCT_DMA DMA_struct[DMA_QTY];

void DMA_init (uint8_t channel)
{ 
    if ((channel >= 0 ) && (channel < DMA_QTY))
    {
        DMA_struct[channel].prev_txfer_state = DMA_TXFER_DONE;
        DMA_struct[channel].txfer_state = DMA_TXFER_DONE; 

        switch (channel)
        {     
            case DMA_CH0:              
                IEC0bits.DMA0IE = 0;                    // Disable DMA0 interrupt
                IFS0bits.DMA0IF = 0;                    // Lower DMA0 interrupt flag           
                break;

            case DMA_CH1:

                IEC0bits.DMA1IE = 0;
                IFS0bits.DMA1IF = 0;
                break;  

            case DMA_CH2:
                IEC1bits.DMA2IE = 0;
                IFS1bits.DMA2IF = 0;
                break; 

            case DMA_CH3:
                IEC2bits.DMA3IE = 0;
                IFS2bits.DMA3IF = 0;
                break; 

            case DMA_CH4:
                IEC2bits.DMA4IE = 0;
                IFS2bits.DMA4IF = 0;
                break;

            case DMA_CH5:
                IEC3bits.DMA5IE = 0;
                IFS3bits.DMA5IF = 0;
                break;   

            case DMA_CH6:
                IEC4bits.DMA6IE = 0;
                IFS4bits.DMA6IF = 0;
                break;      

            case DMA_CH7:
                IEC4bits.DMA7IE = 0;
                IFS4bits.DMA7IF = 0;
                break;   

            case DMA_CH8:
                IEC7bits.DMA8IE = 0;
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
{
    IFS8bits.DMA12IF = 0;
    DMA_struct[DMA_CH12].txfer_state = DMA_TXFER_DONE;
}

void __attribute__((__interrupt__, no_auto_psv))_DMA13Interrupt(void)
{
    IFS8bits.DMA13IF = 0;
    DMA_struct[DMA_CH13].txfer_state = DMA_TXFER_DONE;
}

void __attribute__((__interrupt__, no_auto_psv))_DMA14Interrupt(void)
{
    IFS8bits.DMA14IF = 0;
    DMA_struct[DMA_CH14].txfer_state = DMA_TXFER_DONE;
}
