lecejeff/dsPeak/(commit log)

2021-01-10 Mise à jour des gerbers
    [dsPeak-v1_00-0a-1-4.drl]
2021-01-10 Mise à jour des fichiers de fab
2021-01-10 Added updated version of gerbers zip file
2021-01-10 Update of the manufacturing files Missed a track / via on the newly removed parallel resistor on the codec HP output
    [dsPeak-v1_00-0a-1-4.drl]
2021-01-10 Added gerberViewer project, use Gerbv 2.6A to view the gerbers
2021-01-10 Added wettings on analog input ports updated schematics and pcb accordingly
    [dsPeak-v1_00-0a-1-4.drl]
2021-01-11 Added schematics pdf
2021-01-13 Moved files to Hardware / v1_00-0a folder for any other revision
    [dsPeak-v1_00-0a-1-4.drl]
2021-01-13 UPdate of the folder hierarchy
    [dsPeak-v1_00-0a-1-4.drl]
2021-01-17 Added 3d prints .stl and .gcode files for dsPeak enclosure Rev1
    [dsPeak base.stl, dsPeak top.stl]
2021-01-17 Updated 3d enclosure top side, more extrusion on text Started porting ADC.c file for dsPeak
    [dsPeak top.stl]
2021-01-17 Added uSD card slot and USB host / debug port slot on TOP enclosure
    [dsPeak top.stl]
2021-01-18 Update of ADC.c file, porting to dsPeak Update of Main.c file, fixed clock switching with main oscillator
    [ADC.h, main.c]
2021-01-19 Code reformatting for SPI module
2021-01-25 Added a bug list following the soldering of the 1st PCB Added a datasheets/3D_CVM_CVM_1558666-1_B.pdf
    Added FT8XX library files to the software repo
    Modified the SPI.c file to support the dsPeak platform
    Managed to get a sample application running on the FT8XX, confirming the SPI port 1 works
    [Timer.c, Timer.h, main.c, spi.h]
2021-01-28 Update to the software : 1) UART3 port (dsPeak debug port) is up and running @ 9600, 8n1, both TX and RX 2) Main demo waits for a character to be received, then transmits "OK"
    Update to the v1_00-0a schematic :
    1) Added note for the flipped USB footprint
    2) Added note for the MIC pad holes to be increased
    [Timer.c, UART.c, UART.h, main.c, spi.h]
2021-01-30 Updated UART transmit to interrupt Added notes to schematics for hardware revision
2021-02-01 Added SPI flash memory datasheets Started working on DCI module and SGTL5000 I2S codec
2021-02-06 Removed QEI_general.h since it's usage is not appropriate in the software architecture put in place Modified schematic comments, 2x capacitors become DNP on both LDO (3V3, 5V0), removes oscillations 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
    [QEI.h, UART.h, codec.c, codec.h, main.c, pwm.c, pwm.h]
2021-02-14 Modified schematics with Pololu motor header comment, swapped Encoder +5V and GND Added mCOntrol.c and spi_flash.c and some code to do preliminary testing
    [codec.c, codec.h, main.c, mcontrol.h, pwm.c, pwm.h, spi.h]
2021-02-23 Added daughter card (some folders) Updated code
    [daughter_card-v1_00-0a-1-4-1-4.drl]
2021-02-23 Adding output files, pdf drawings and related stuff for daughter card
    [DAUGHTER_CARD-V1_00-0A_ulbom.csv, daughter_card-v1_00-0a.stp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]
2021-02-23 Updated gerbers and output files
    [daughter_card-v1_00-0a.stp]
2021-03-09 Update to dsPeak-v1_00-0b schematics, BOM preparation Update to some code in the software library Added daughter card PCB and schematic files
    [DAUGHTER_CARD-V1_00-0A.DSN, Daughter_Card-v1_00-0a.opj, Daughter_card-v1_00-0a.stp, cases.cfg, daughter_card-v1_00-0a.brd]
2021-03-18 Added v1_00-0b schematics, PCB, pdf, output files and gerbers to the repository Added new files in the software
    [DSPEAK-V1_00-0B.opj, DSPEAK-V1_00-0B_ulbom.csv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]
2021-03-18 Removed DSNlck and BRD lck files
    [DSPEAK-V1_00-0B.opj]
2021-03-18 Modified termination resistor part to be 0805
    [DSPEAK-V1_00-0B.opj]
2021-03-19 Update mic footprint on PCB v1_00-0b Generated all the export files for manufacturing
    [DSPEAK-V1_00-0B.opj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]
2021-03-26 Updtated GERBERS output as of 2021-03-25
    [dsPeak-v1_00-0b-1-4.drl]
2021-03-26 Updated BOM as of 2021-03-25
    [DSPEAK-V1_00-0B_ulbom.csv]
2021-03-26 PCB IPC2581 file up to date as of 2021-03-25
2021-03-26 Schematics PDF and PCB PDF files up to date as of 2021-03-25
2021-03-26 dsPeak PCB STEP file up to date as of 2021-03-25
2021-03-26 Design files for SCH and PCB with ORCAD 17.4 up to date as of 2021-03-25
    [DSPEAK-V1_00-0B.opj]
2021-03-28 Updates to dsPeak-v1_00-0B schematics and PCB files Export of updated schematics (pdf) Export of updated BOM Export of updated Gerbers Export of updated PCB (pdf) Up to date as of 2021-03-28
    [DSPEAK-V1_00-0B.opj, DSPEAK-V1_00-0B_ulbom.csv, Daughter_Card-v1_00-0a.opj, daughter_card-v1_00-0a.brd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]
2021-03-28 Updates to dsPeak software bringup CAN - PMP - ST7735 and DMA
2021-03-29 Moved Daughter card interface to v1_00-0a subfolder for version control
    [DAUGHTER_CARD-V1_00-0A.DSN, DAUGHTER_CARD-V1_00-0A_ulbom.csv, Daughter_Card-v1_00-0a.opj, Daughter_card-v1_00-0a.stp, cases.cfg, daughter_card-v1_00-0a.brd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]
2021-04-02 Schematic update : Added CODEC_1V8_EN signal to control 1V8 LDO -> Used to do a hardware reset of SGTL5000 Added pulldown resistor for that signal, #SHDN by default Updated .pdf output file
    PCB update
    Traces placement updated
    Gerbers and output files updated
    [DSPEAK-V1_00-0B.opj, DSPEAK-V1_00-0B_ulbom.csv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]
2021-04-02 PCB output file pdf
2021-04-03 Saved capture
    [DSPEAK-V1_00-0B.opj]
2021-04-06 Code refactor, cleanup and documentation Did SPI, UART and Timer .c and .h
2021-04-09 Working to add CAN RX through DMA_CH2 Need to work on receive filter, acceptance mask and buffer pointer from DMA to message buffer
2021-04-09 Added case in DMA_init_struct() to initialize all DMA channel struct variables in one function call
2021-04-12 Update of code. Adding comments and function prototype documentation Added code to control DAC 5 click board for Analog input bringup
2021-04-16 BOM export update as of 2021-04-16
    [DSPEAK-V1_00-0B_ulbom.csv]
2021-07-07 Push of "coming back after leaving for 3 months"
    [DSPEAK-V1_00-0B.opj]
2021-08-31 Bringup dsPeak rev2 update - Modified CAN code to support up to 550kbps as stated in dsPeak schematics - Updated FT8XX library, added support for CMD_TRACK - Updated UART, RS_485 port now works in bo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
2021-09-26 Updated code Added rotary encoder support
    [DSPEAK-V1_00-0B.opj]
2022-01-03 Added support for 24LCXXX I2C eeproms Modified uart and i2c library, added functions modified dsPeak rev 1_00-0b sch pdf, added note about I2C resistor standard value to be changed to 4.7kOhm
2022-02-07 Added UART with Tx DMA support on dsPeak Updated the test project with RS-485 test on both dsPeak and a MikroE RS485 6 ClickBoard
2022-02-12 Modified UART and SPI library to adopt a struct-type input approach
2022-02-20 Updating various drivers to support DMA All drivers working principle will now be based on a struct pointer
2022-02-28 Updated codec and uart drivers Both now support DMA I2S - Transmit and receive through DMA UART - Transmit through DMA
    Codec has new functions to set the audio path (input to output)
    Preliminary DAP (digital audio processing) being added slowly
2022-03-27 Library update to use structures pointers to initiate driver instantiation added datasheets
2022-08-21 Audio recorder + playback now works again, this commit serves as a version freeze Updated test application and drivers :
    CAN.c
    DMA.c
    FT8XX.c
    UART.c
    codec.c
    i2c.c
    spi.c
    spi_flash.c
    All drivers are now using struct pointers as function argument
2022-09-15 Update of various libraries to make them structure oriented Main project still consists of audio recorder + playback using DMA
    To work on :
    UART_MKB hardcoded DMA_tx_done on DMA_1 -> make it portable to any DMA port
    Migrate DMA functions to structure oriented with structures in associated hardware peripheral
    SPI -> DMA -> [structure elements]
2022-09-20 Updated the following files :
    DMA -> Added support for setting DMA states, reading DMA force bits and other struct elements
    SPI -> Corrected SPI interrupt bug where some data (unwanted..) was still present in the RXFIFO and would cause a SPI module hang
    codec ->
    main.c -> added CODEC live volume adjustment during playback, with non blocking functions calls
    [DMA.c, DMA.h, UART.c, codec.c, dsPeak_generic.c, main.c, spi.h]
2022-09-24 Added seperate MPLAB X project for audio record + playback demo with DMA
2022-09-24 Updated typos in UART library
2022-09-24 Added notes on schematic about bugs found on 1st revision
    [Daughter_Card-v1_00-0a.opj]
2023-02-22 Updated libraries as follow
    - Added BNO080 driver (in-progress)
    - Update I2C library (add stop - start ready byte support instead of "always on restart" read scheme)
    - Updated mcontrol library to support backwards velocity closed-loop control
    - Updated QEI.C to return absolute velocity, negative velocity not relevant in current PID control (using float instead of fixed point for bring-up)
    -
    [BNO080.c, BNO080.h, codec.c, codec.h, dsPeak_generic.c, dsPeak_generic.h, i2c.c, i2c.h]
2023-02-22 Update test projects, purpose of current dev project is to stabilize a 2-wheel robot with the BNO080
    [main.c]
2023-02-22 Added BNO080 stabilized 2-wheeled dsPeak robot project in the source control Current status
    - Successful initialization and readback of basic sensors in BNO080 using I2C (accel, gyro, magneto)
    - Successful bidirectional motor control implementation with velocity fedback
    - Right now, must characterize the physics of the system and tune PID
    [main.c]
